Improbable-Association/ISS/plans_enceintes/hornplans-marc-o-mth-4654-169785.jpg

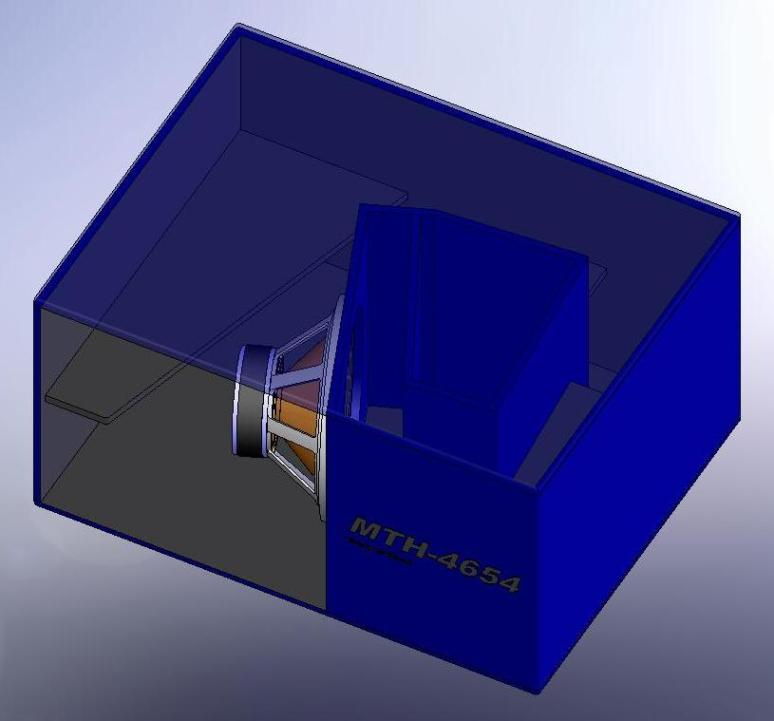
plans_enceintes/hornplans-marc-o-mth-4654-169785.jpg
