Improbable-Association/ISS/plans_enceintes/plan_iss_medium.docx

Tf0818

3cm-e

30cm+2*e

21.8cm+2*e+2cm

D=18.5cm

25.3cm

4.7cm

25.9cm
