Improbable-Association/ISS/plans_enceintes/bbc br215 modif 12 tricone.odt

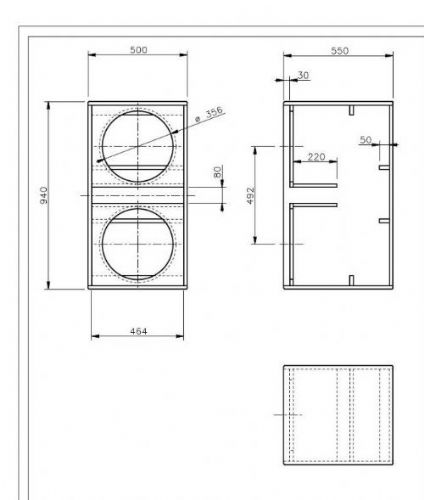
[picture p7: figure]

536 285,75 836 366 500 102 32 349 451
