Improbable-Association/ISS/2022-11-07-Cablage-ISS-4654-triple-DE10-STEREO.pdf

# Fiche d’installation Improbable Sound System + MTH4654s + Triple + DE10 + STEREO

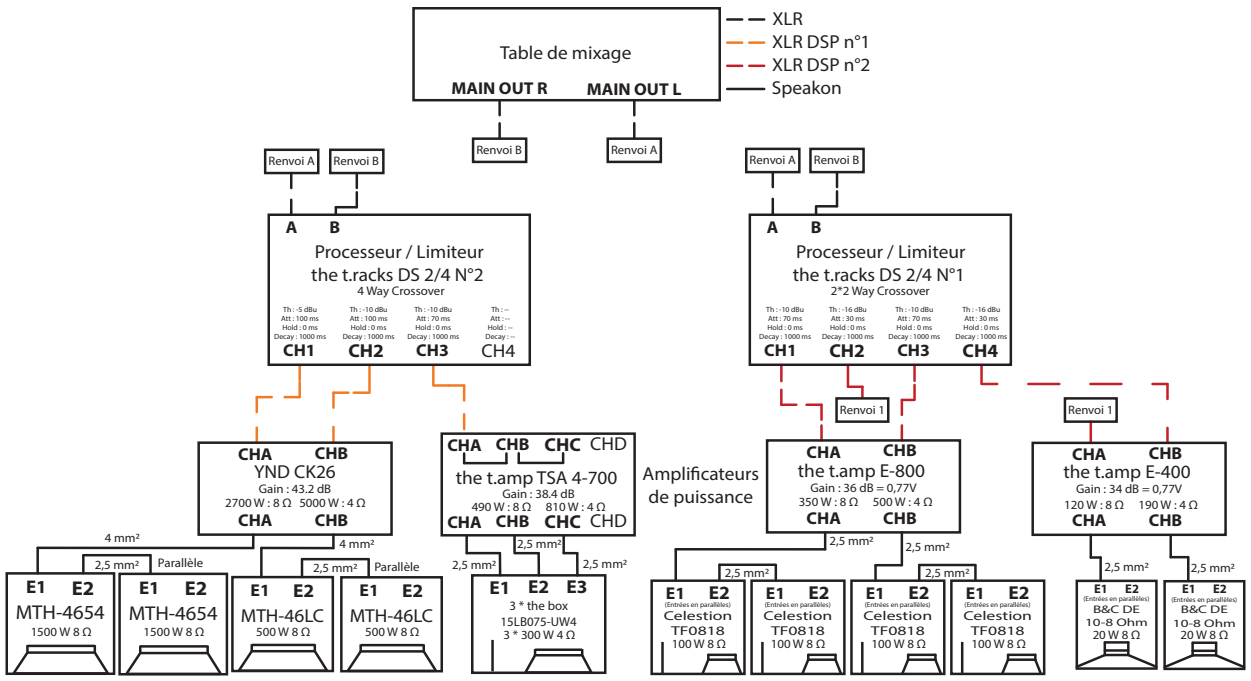
[picture p14: figure]
Amplicateurs de puissance; XLR DSP n°2 Speakon; XLR XLR DSP n°1; Parallèle; Table de mixage; MAIN OUT R; MAIN OUT L; E1 E2 MTH-4654; Celestion TF0818; E1 E2 (Entrées en parallèles); 3 * the box 15LB075-UW4; E1 E2 MTH-46LC 500 W 8 Ω; CHA; CHB; YND CK26 Gain : 43.2 dB; CHA CHB CHC CHD; the t.amp TSA 4-700 Gain : 38.4 dB; the t.amp E-800; Gain : 36 dB = 0,77V 350 W : 8 Ω 500 W : 4 Ω; the t.amp E-400; Gain : 34 dB = 0,77V 120 W : 8 Ω 190 W : 4 Ω; Processeur / Limiteur the t.racks DS 2/4 N°2; Th : -5 dBu Att : 100 ms Hold : 0 ms Decay : 1000 ms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
Sur le DS 2/4; Xover sub menu; MENU; ENTER; Load a Xover; Recherche de la conguration avec la molette

# Document réalisé par Florian Vié Contact :

# Téléphone : 06.52.60.95.78

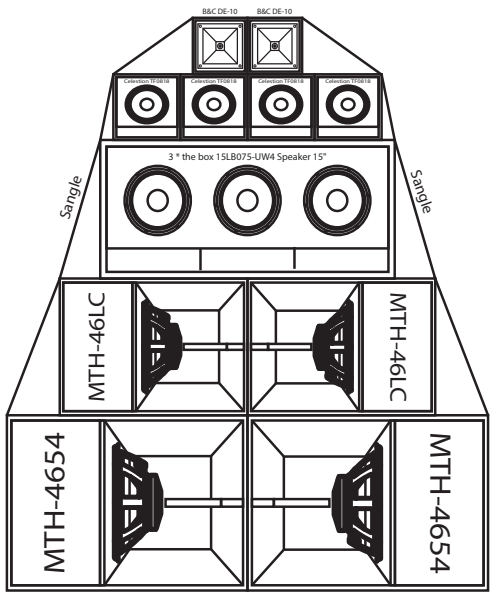
[picture p15: figure]
3 * the box 15LB075-UW4 Speaker 15"; Sangle; MTH-46LC; MTH-4654; Celestion TF0818

# Fiche d’installation Improbable Sound System

# Avertissement :

Les personnes ayant réalisées ces systèmes et écrit cette notice ne sauraient en aucun cas être responsable d’une mauvaise interprétation, mauvais usage, de ces systèmes et de ce document. Il incombe à l’utilisateur d’en faire le bon usage. Si vous avez le moindre doute, contactez les créateurs de ces systèmes et de ce document ou faite régler ces systèmes par un professionnel.

# Mail : vie.orian34@orange.fr

# 4. Choix de la conguration

# ENTER 3. Allumage des appareils

# Monter le volume au maximum :

# YND CK26 : Canal A et B TSA 4-700 : Canal A, B, C E-800 : Canal A et B E-400 : Canal A et B

# 2. Diposition des enceintes

# En stack (par défaut)

# 1. Mise en place de la régie

2700 W : 8 Ω 5000 W : 4 Ω | 490 W : 8 Ω 810 W : 4 Ω
Renvoi B | Renvoi A Renvoi A | Renvoi B | Renvoi A | Renvoi B
