Improbable-Association/ISS/plans_enceintes/c15modif.pdf

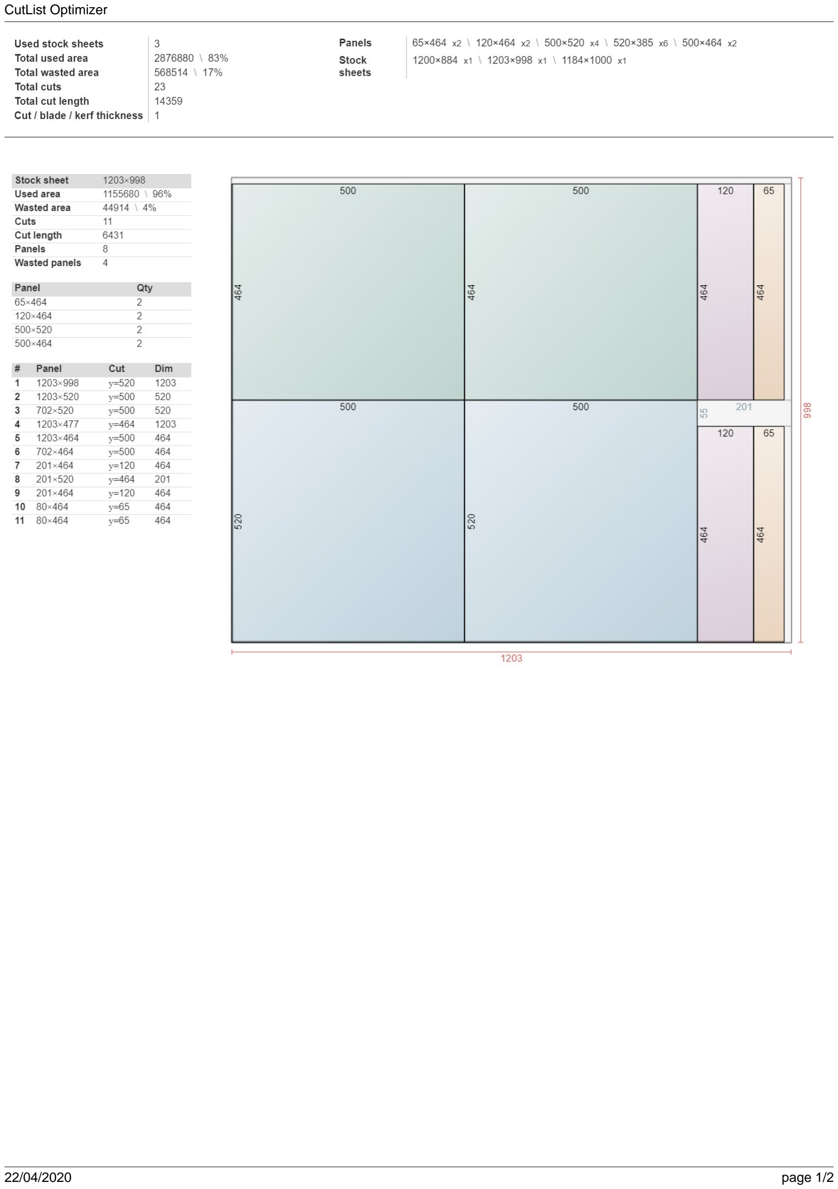
[picture p16: page 1]

CutList Optimizer

22/04/2020 | page 1/2

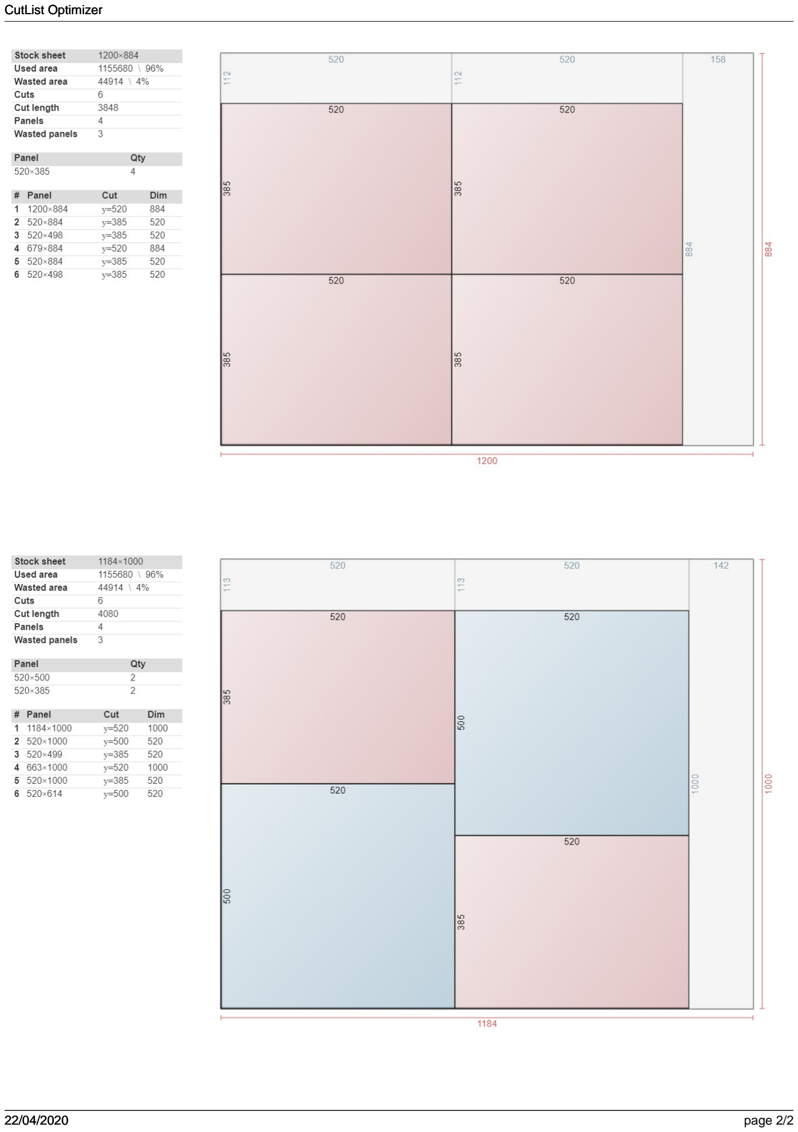
[picture p17: page 2]

CutList Optimizer

22/04/2020 | page 2/2
