Improbable-Association/ISS/plans_enceintes/focal 165 pc laminaire.pdf

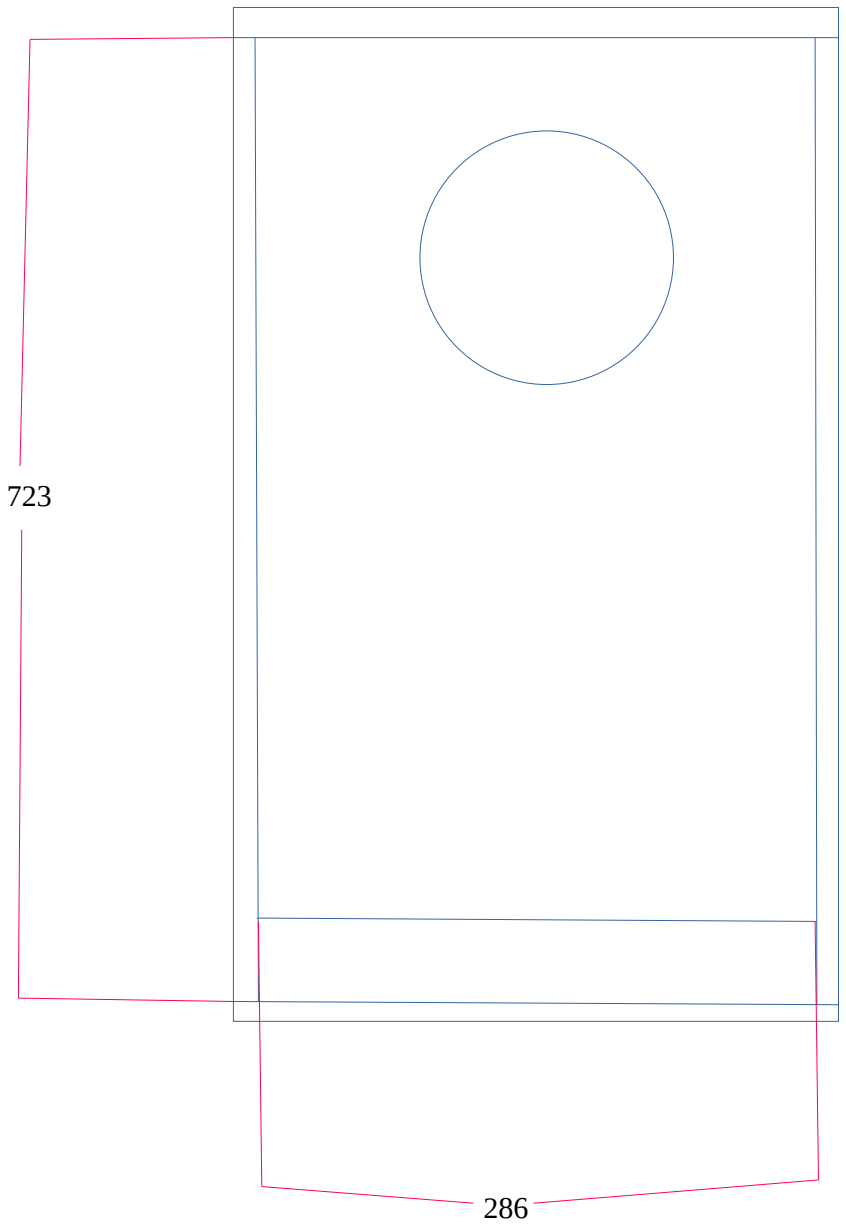
[picture p18: figure]

461

20

47
