Improbable-Association/ISS/plans_enceintes/mhb plan.pdf

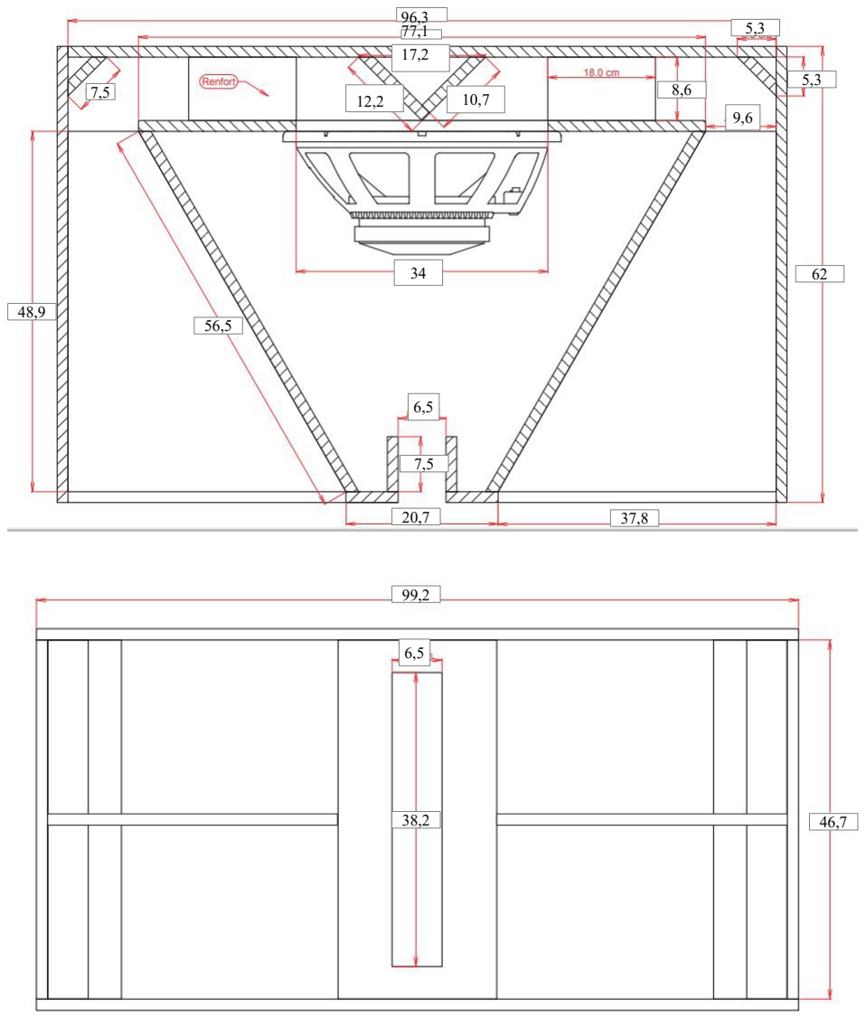
[picture p19: page 1]

96,3
77,1
17,2
12,2 | 10,7 7,5

5,3

5,3 8,6

9,6

34 | 62

48,9
56,5

6,5

7,5

20,7 | 37,8

99,2

38,2

6,5

46,7
