Improbable-Association/ISS/plans_enceintes/mkh 230 plaque leroy.pdf

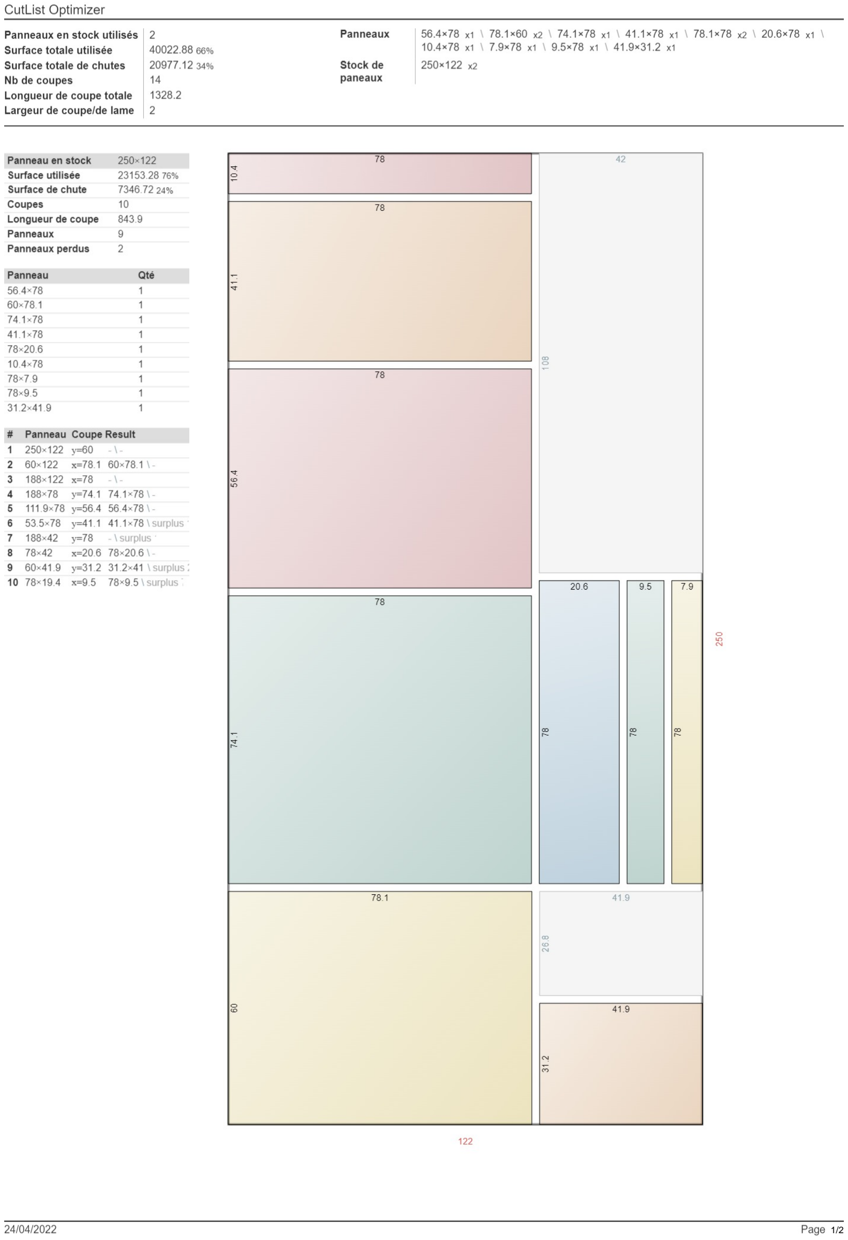
[picture p20: page 1]

1/2

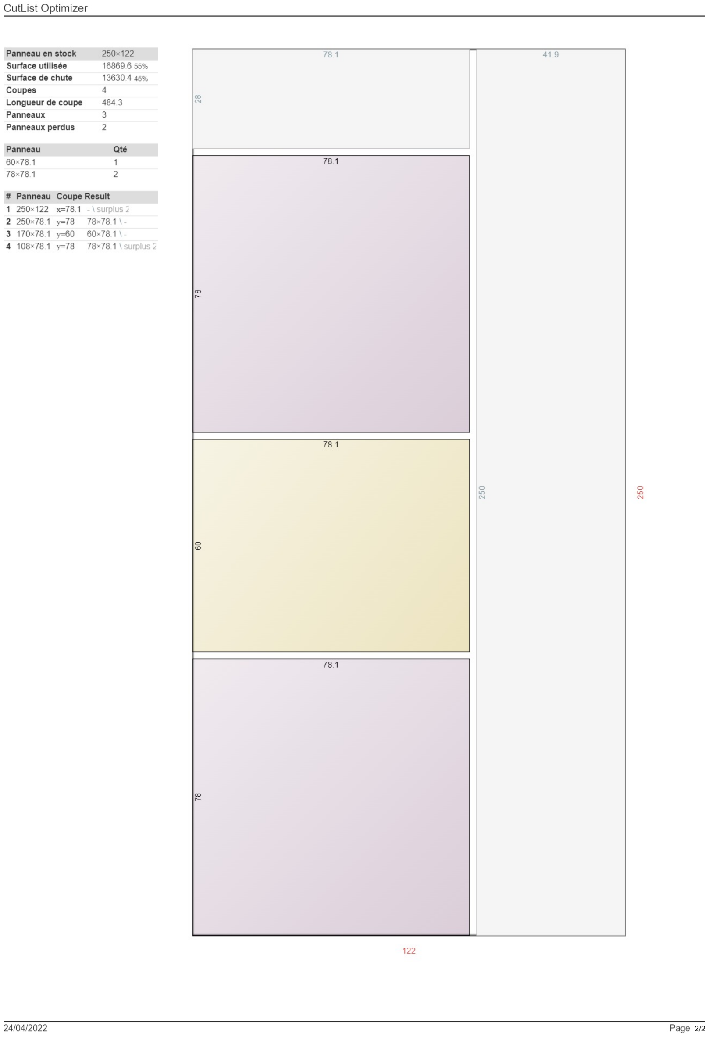
[picture p21: page 2]

2/2
