Improbable-Association/ISS/plans_enceintes/SAKB28 Plan.pdf

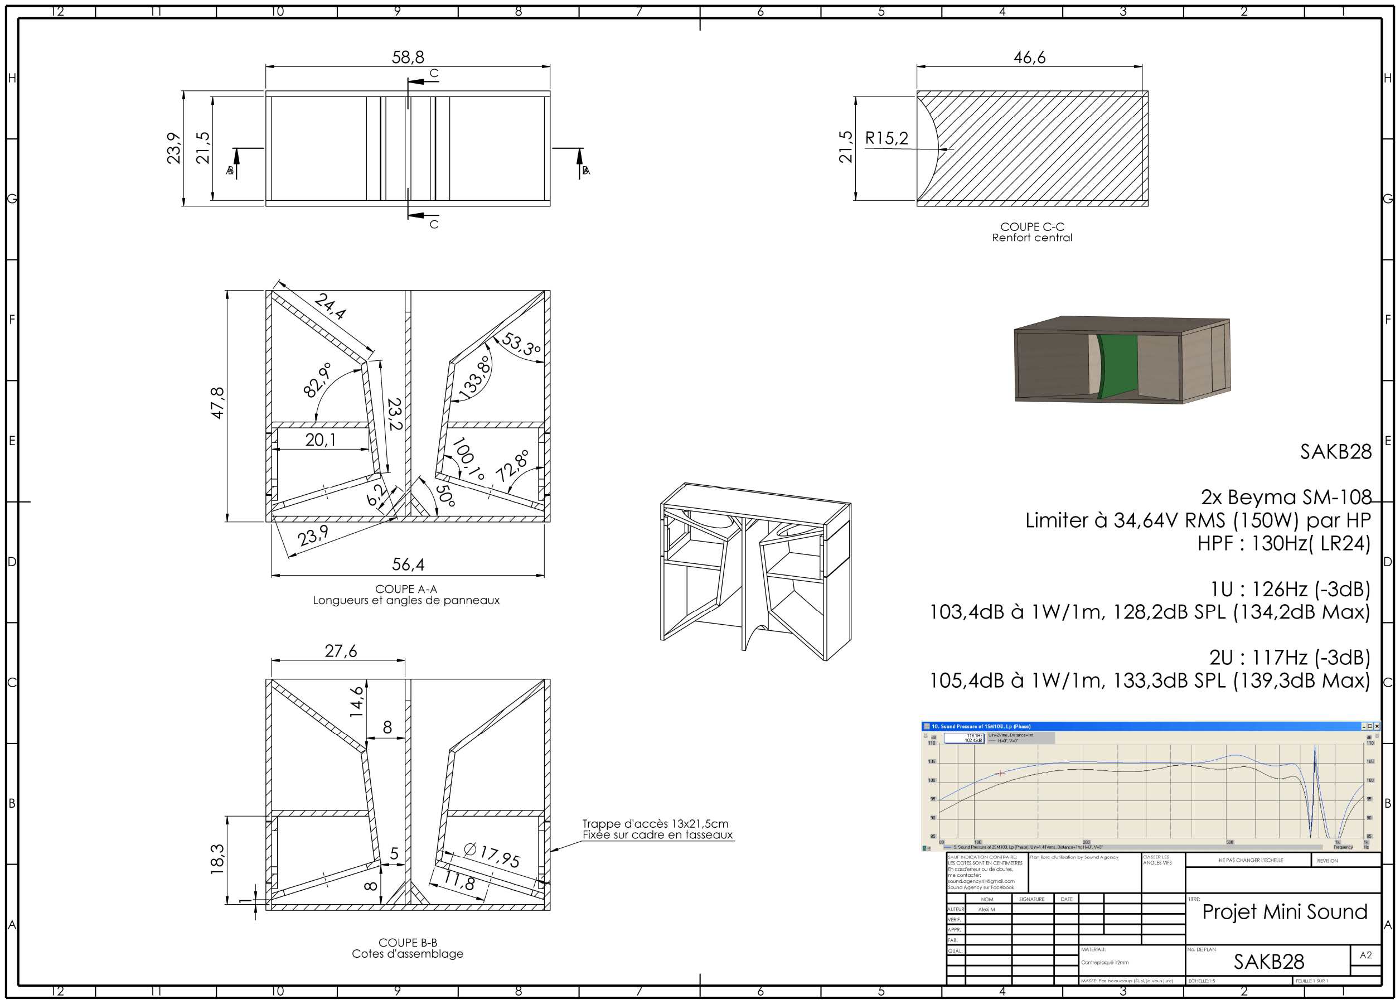
[picture p22: page 1]
