Improbable-Association/ISS/plans_enceintes/Tham 15 modifie.pdf

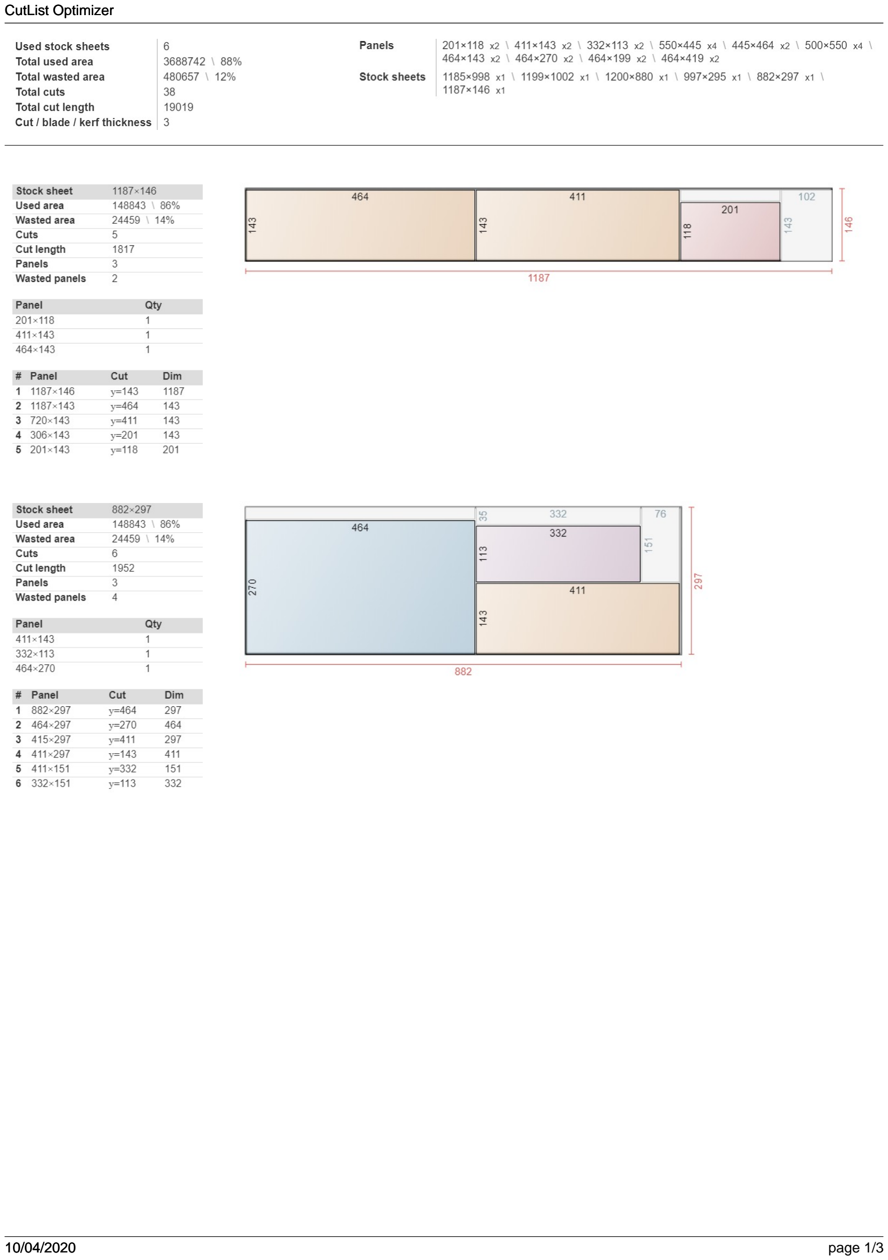
[picture p23: page 1]

CutList Optimizer

10/04/2020 | page 1/3

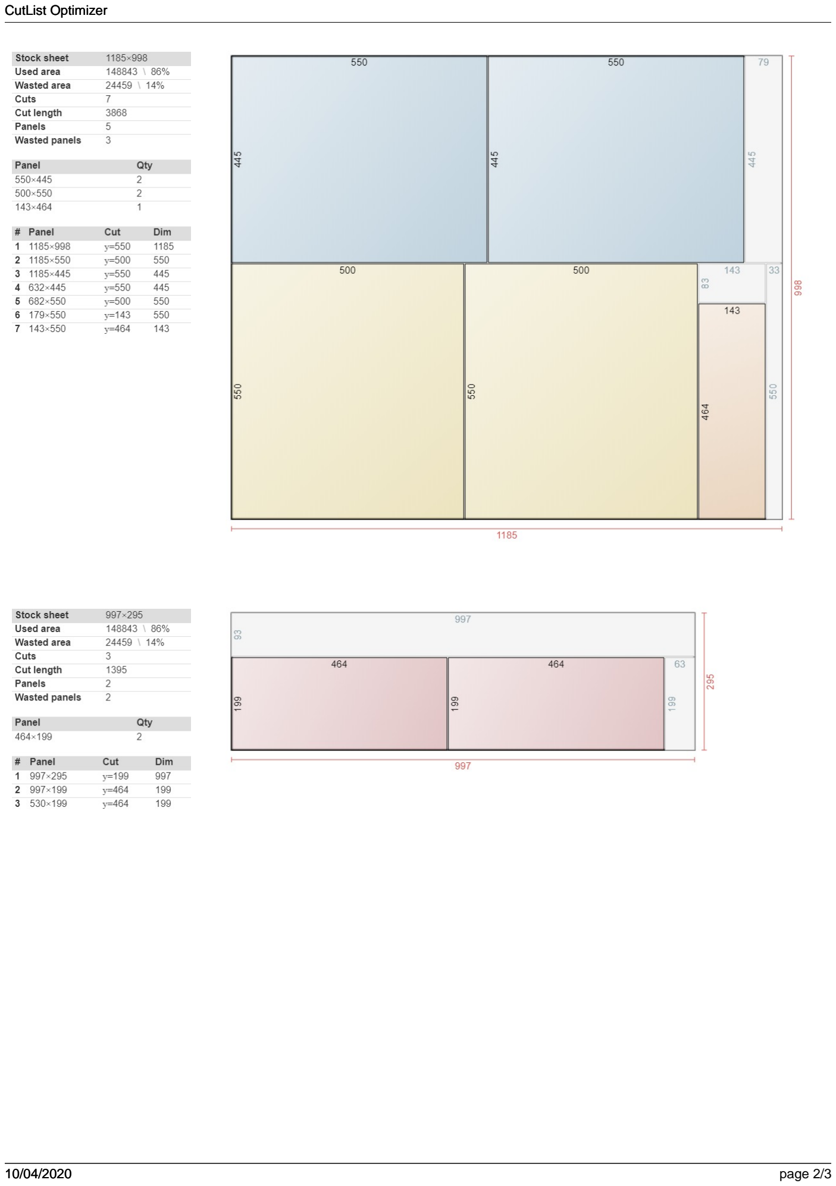
[picture p24: page 2]
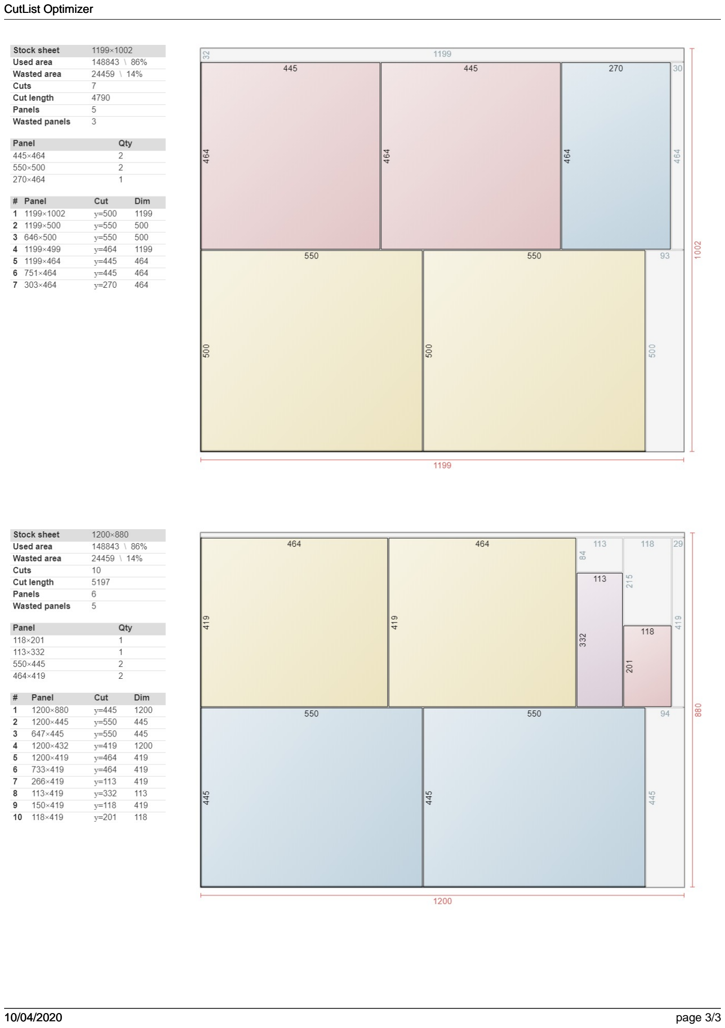
[picture p25: page 3]
