Improbable-Association/ISS/plans_enceintes/tham 15.pdf

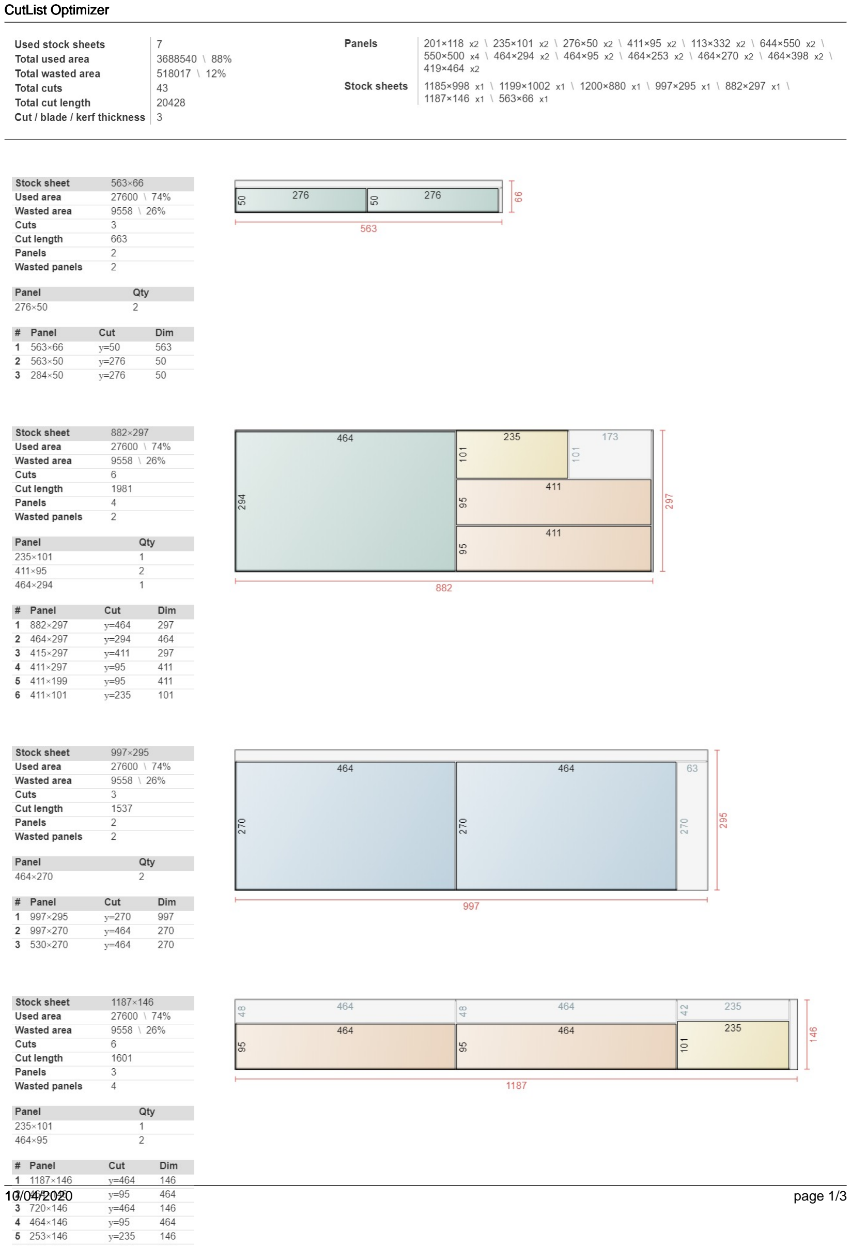
[picture p26: page 1]

CutList Optimizer

10/04/2020 | page 1/3

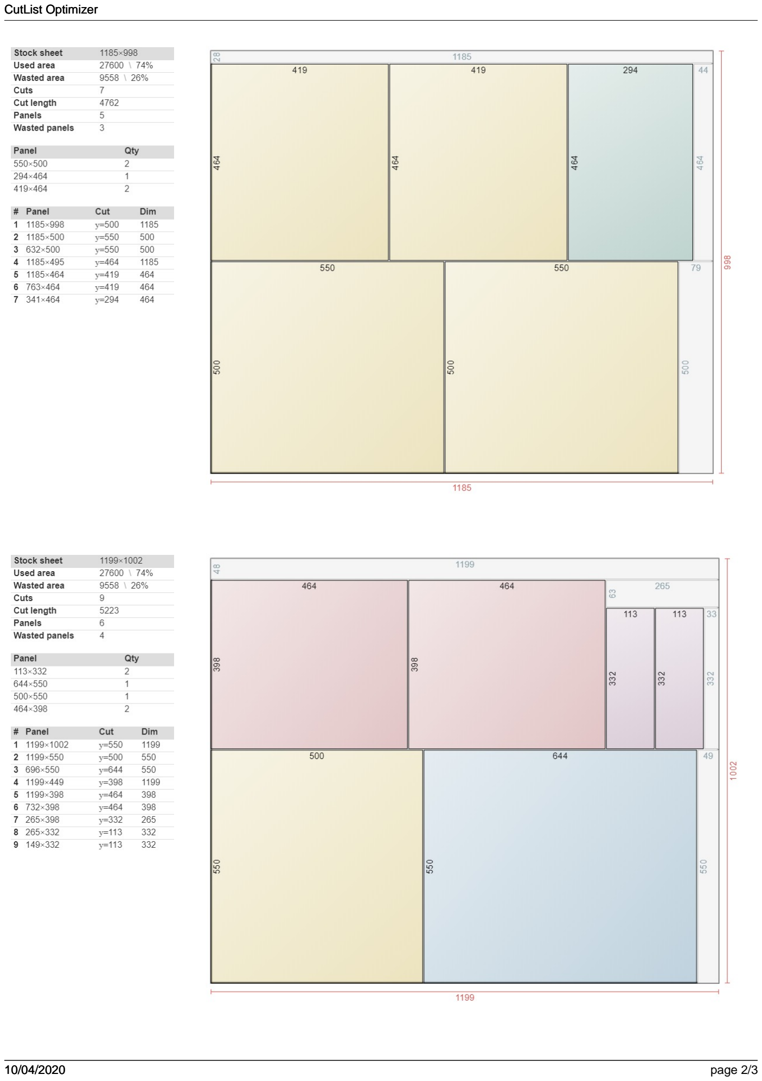
[picture p27: page 2]
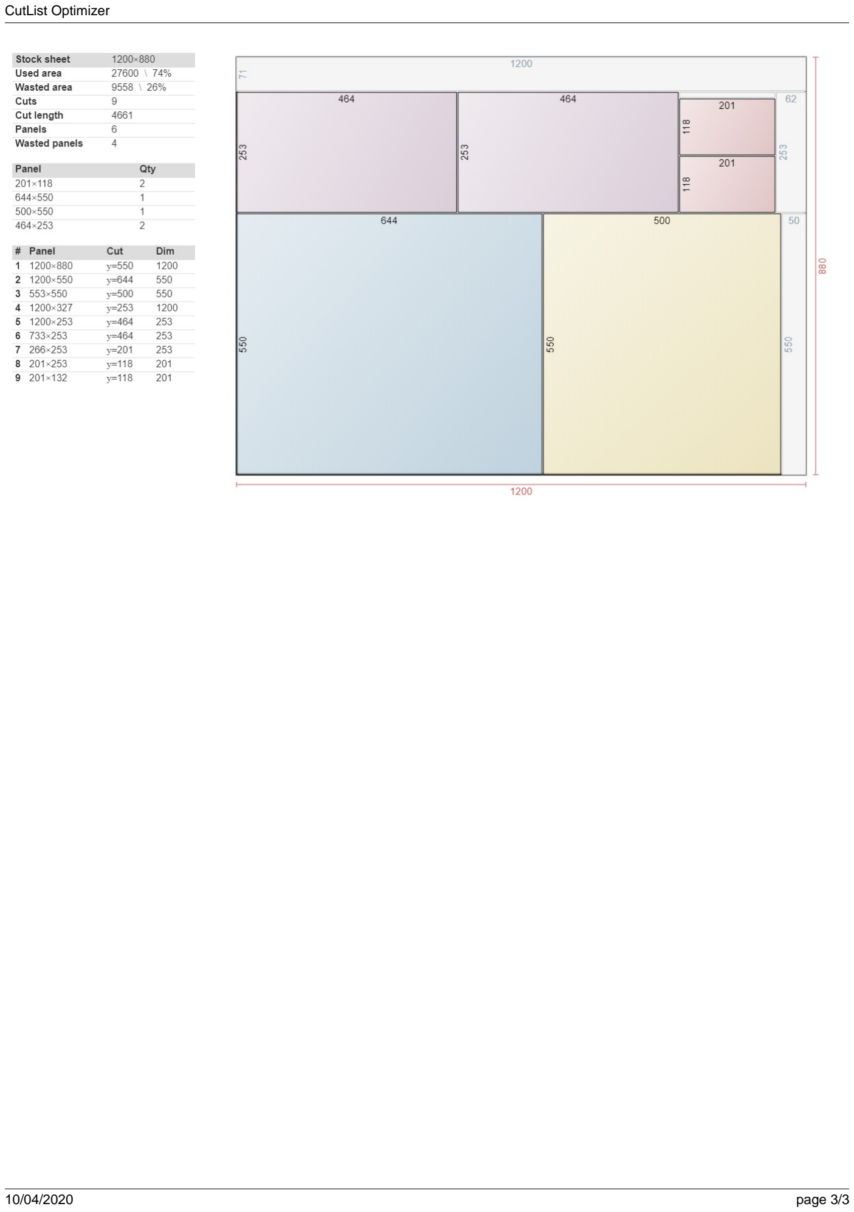
[picture p28: page 3]
