Improbable-Association/ISS/plans_enceintes/triple15thomann-planches.pdf

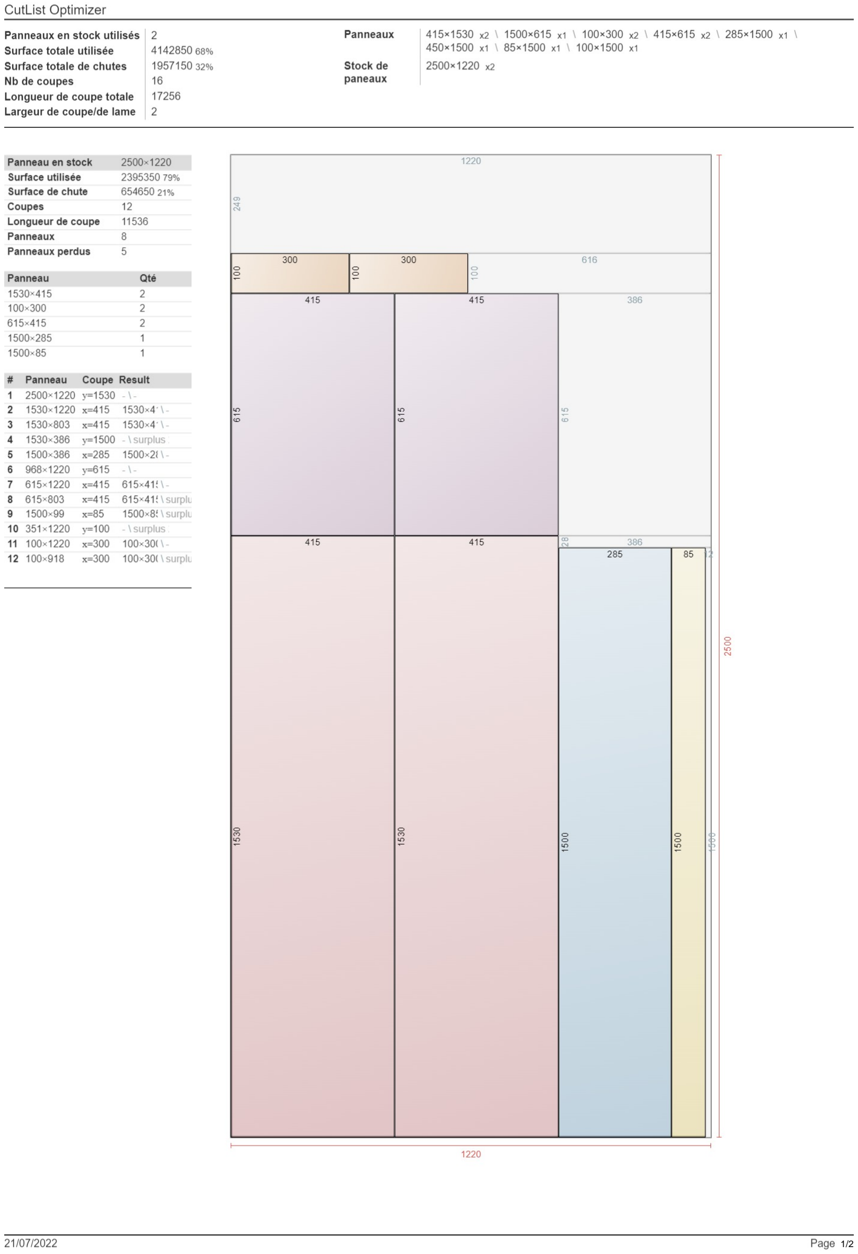
[picture p29: page 1]

1/2

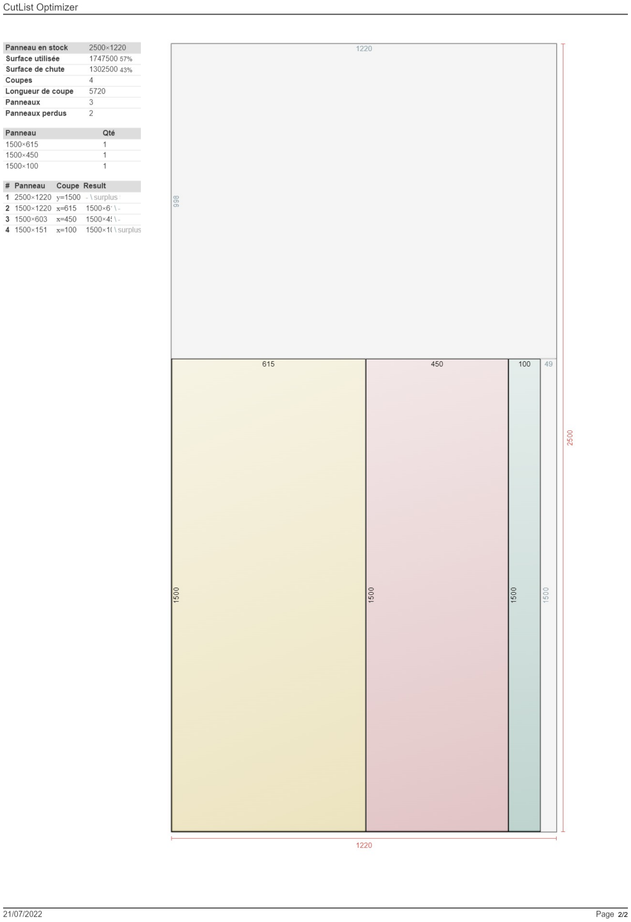
[picture p30: page 2]

2/2
