Improbable-Association/ISS/plans_enceintes/c15 modif.jpg

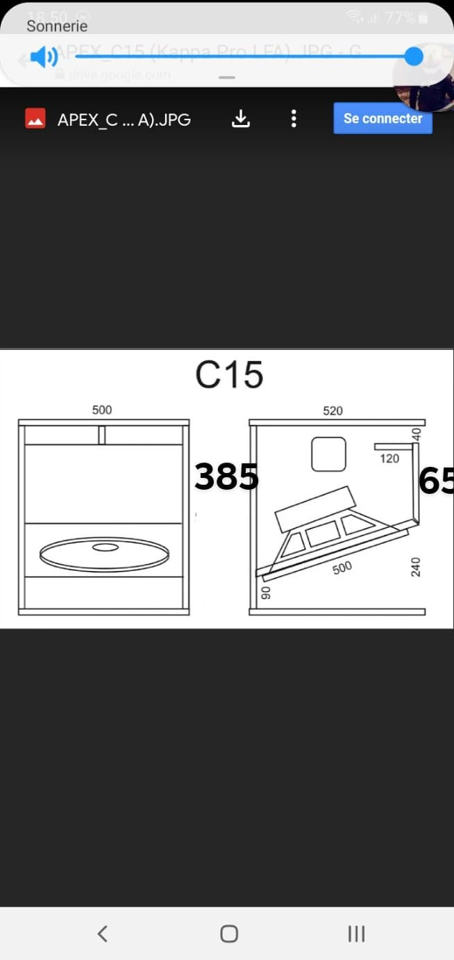
plans_enceintes/c15 modif.jpg
