Improbable-Association/ISS/plans_enceintes/compact_v8HYB.step

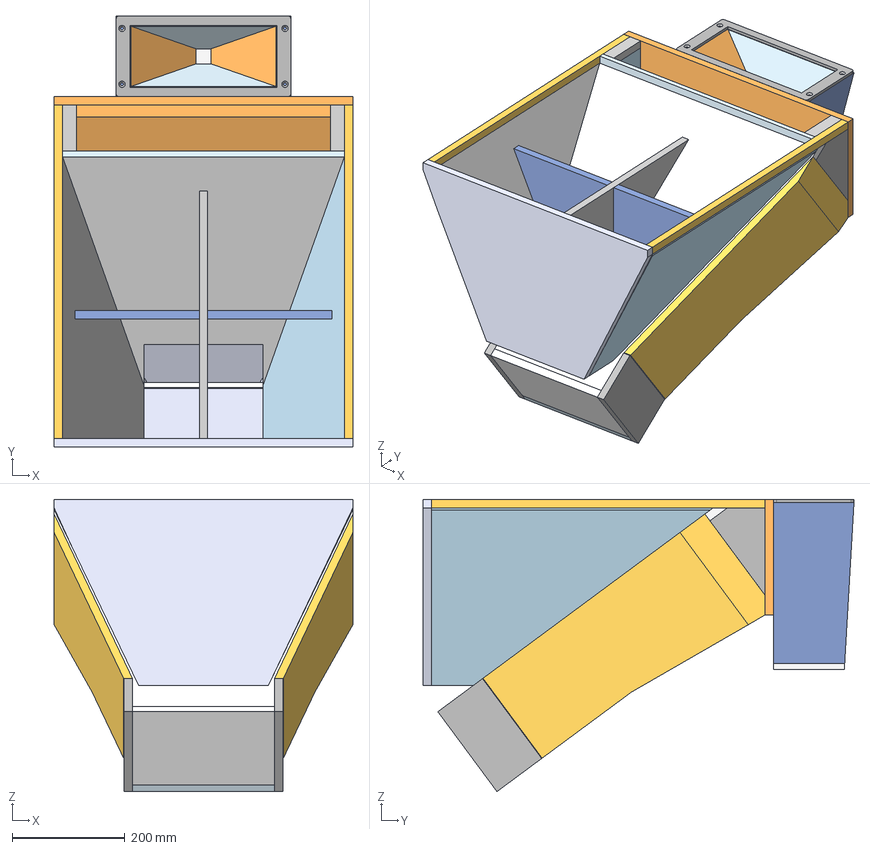
[picture p32: CAD file, 2025-05-29]
plans_enceintes/compact_v8HYB.step
530.0 x 764.6 x 518.4 mm
