Improbable-Association/ISS/plans_enceintes/triple15thomann15mmversion.SLDPRT

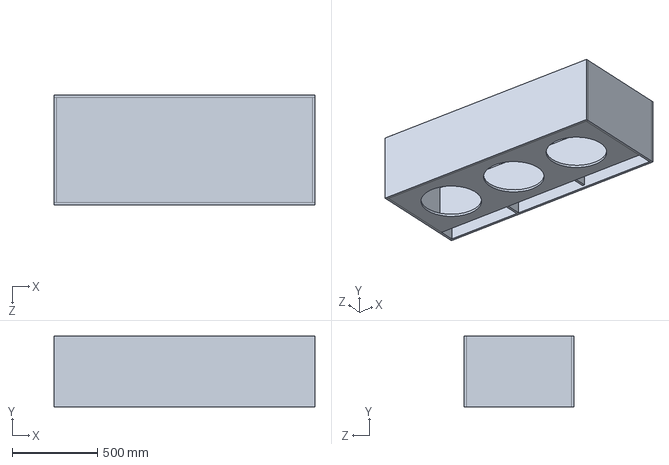
[picture p33: CAD file, 2025-05-28]
plans_enceintes/triple15thomann15mmversion.SLDPRT
1530.0 x 415.0 x 645.0 mm
