Improbable-Association/ISS/plans_enceintes/triple15thomann.SLDPRT

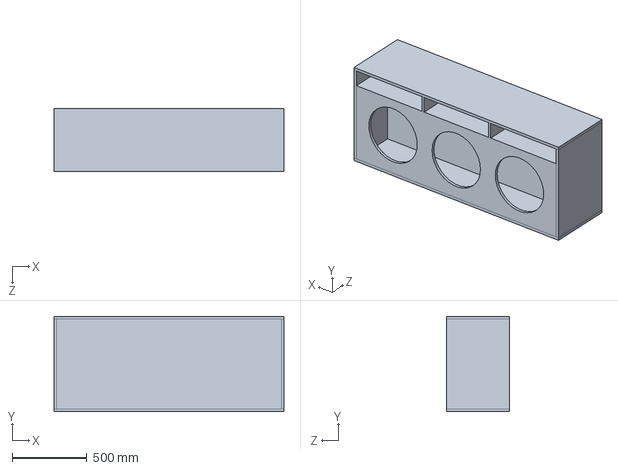
[picture p34: CAD file, 2025-05-28]
plans_enceintes/triple15thomann.SLDPRT
1536.0 x 636.0 x 418.0 mm
