Improbable-Association/ISS/(list of files, cad)

Other CAD files:
plans_enceintes/triple15thomann.SLDDRW
plans_enceintes/triple15thomann15mmversion.SLDDRW
