Improbable-Association/ISS/plans_enceintes/HessBH-Plan-2.pdf

6

5

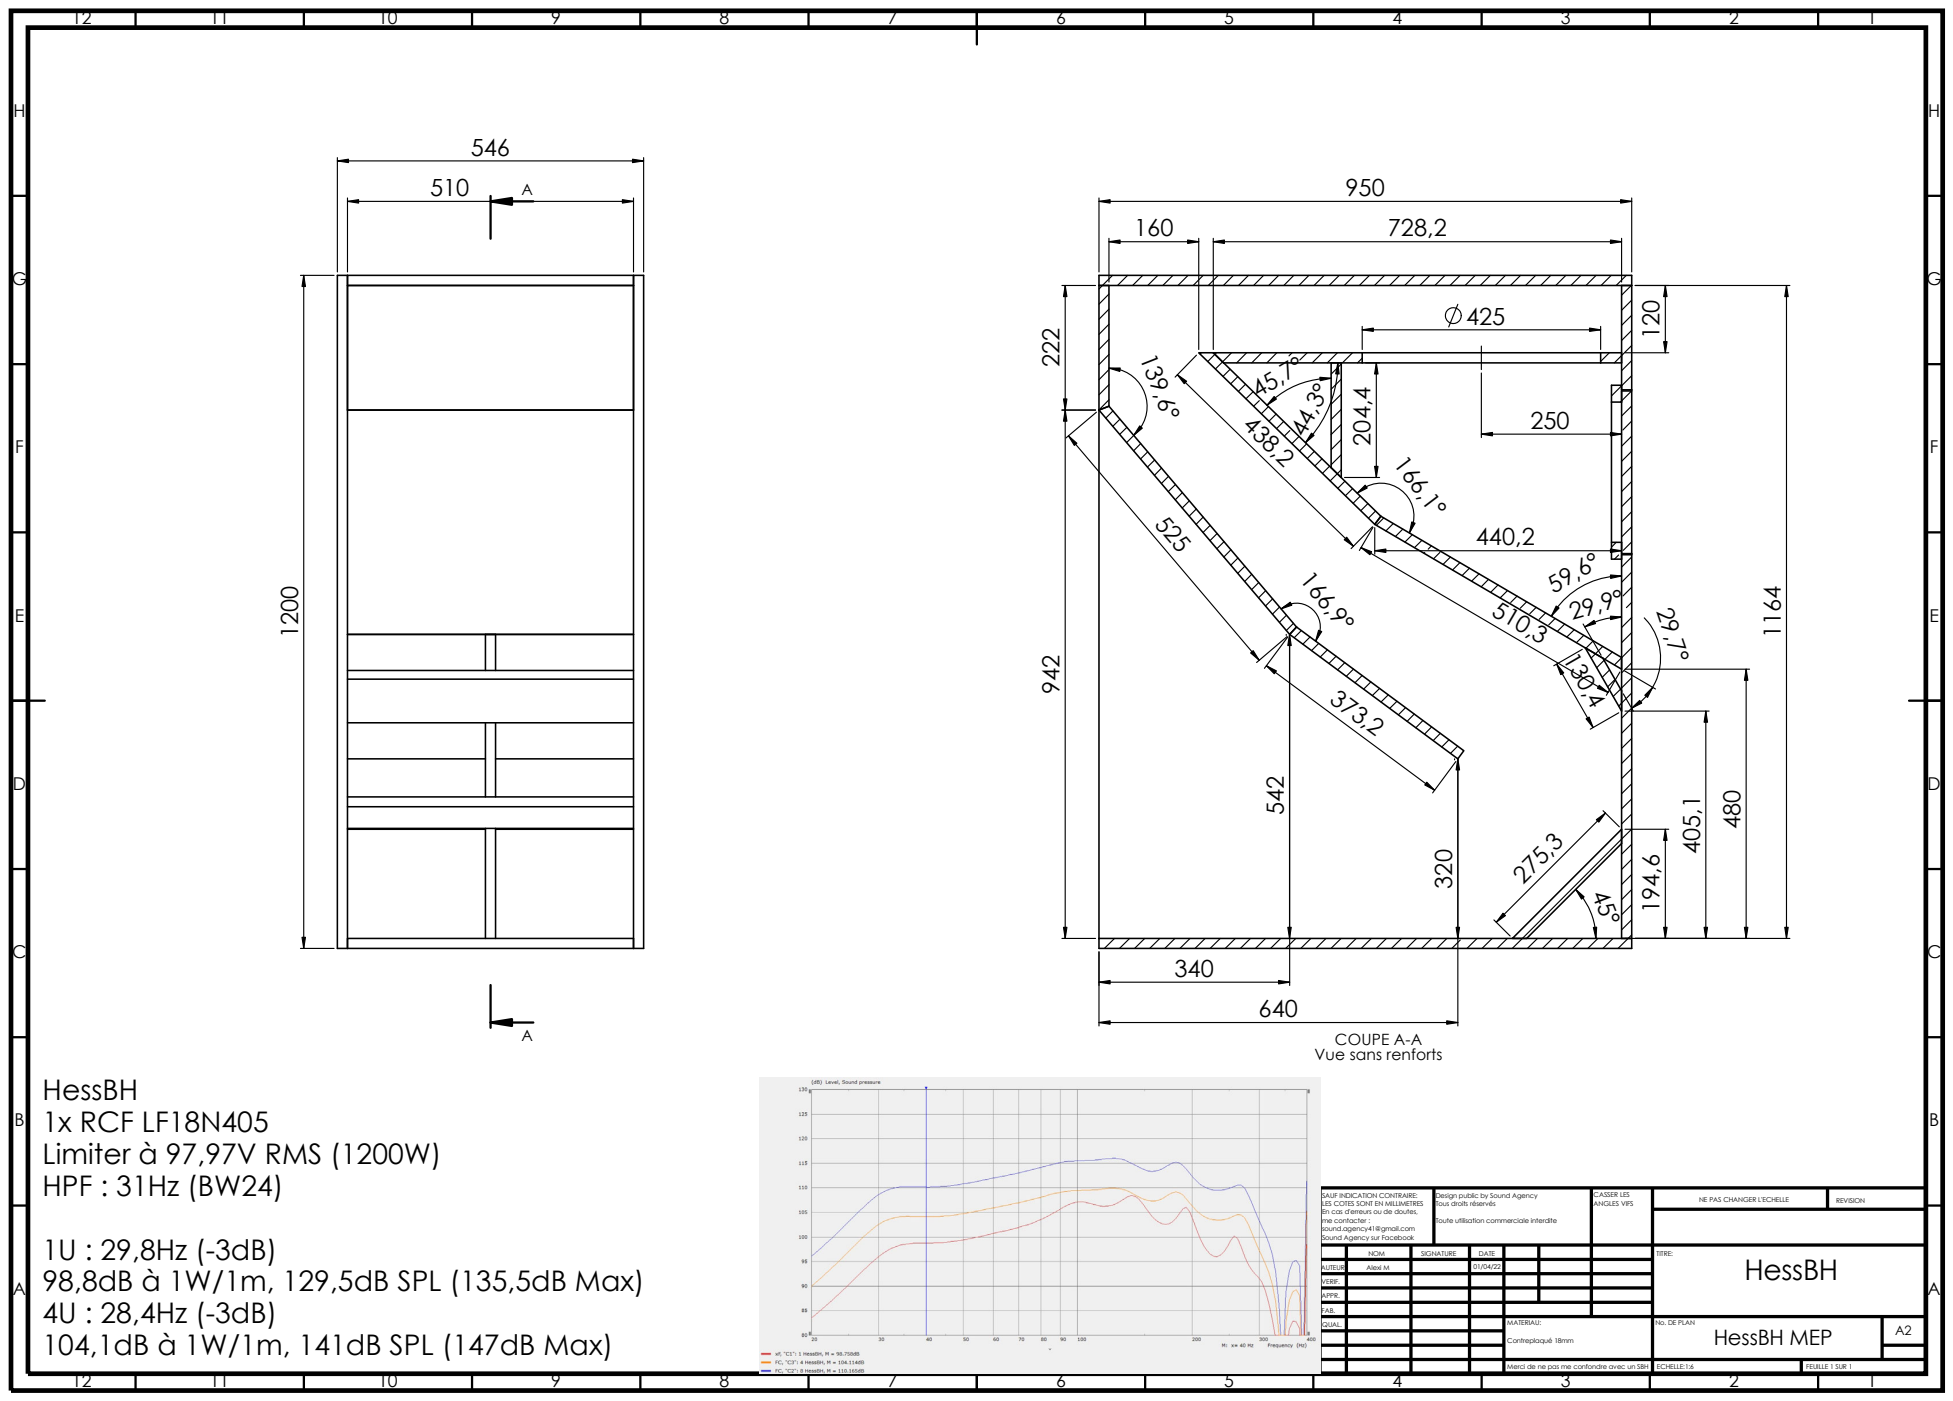
[picture p35: page 1]
HessBH 1x RCF LF18N405 Limiter à 97,97V RMS (1200W) HPF : 31Hz (BW24); 1U : 29,8Hz (-3dB) 98,8dB à 1W/1m, 129,5dB SPL (135,5dB Max) 4U : 28,4Hz (-3dB) 104,1dB à 1W/1m, 141dB SPL (147dB Max); ANGLES VIFS; TITRE:; me contacter :; Toute utilisation commerciale interdite; NOM; SIGNATURE; REVISION; DATE; MATERIAU:; ECHELLE:1:6; FEUILLE 1 SUR 1; Contreplaqué 18mm; Design public by Sound Agency; CASSER LES

COUPE A-A
Vue sans renforts

SAUF INDICATION CONTRAIRE:
LES COTES SONT EN MILLIMETRES
En cas d'erreurs ou de doutes,
sound.agency41@gmail.com
Sound Agency sur Facebook

Tous droits réservés

NE PAS CHANGER L'ECHELLE
HessBH

AUTEUR | Alexi M | 01/04/22
VERIF.
APPR.
FAB. QUAL.

No. DE PLAN
HessBH MEP

Merci de ne pas me confondre avec un SBH

914

2

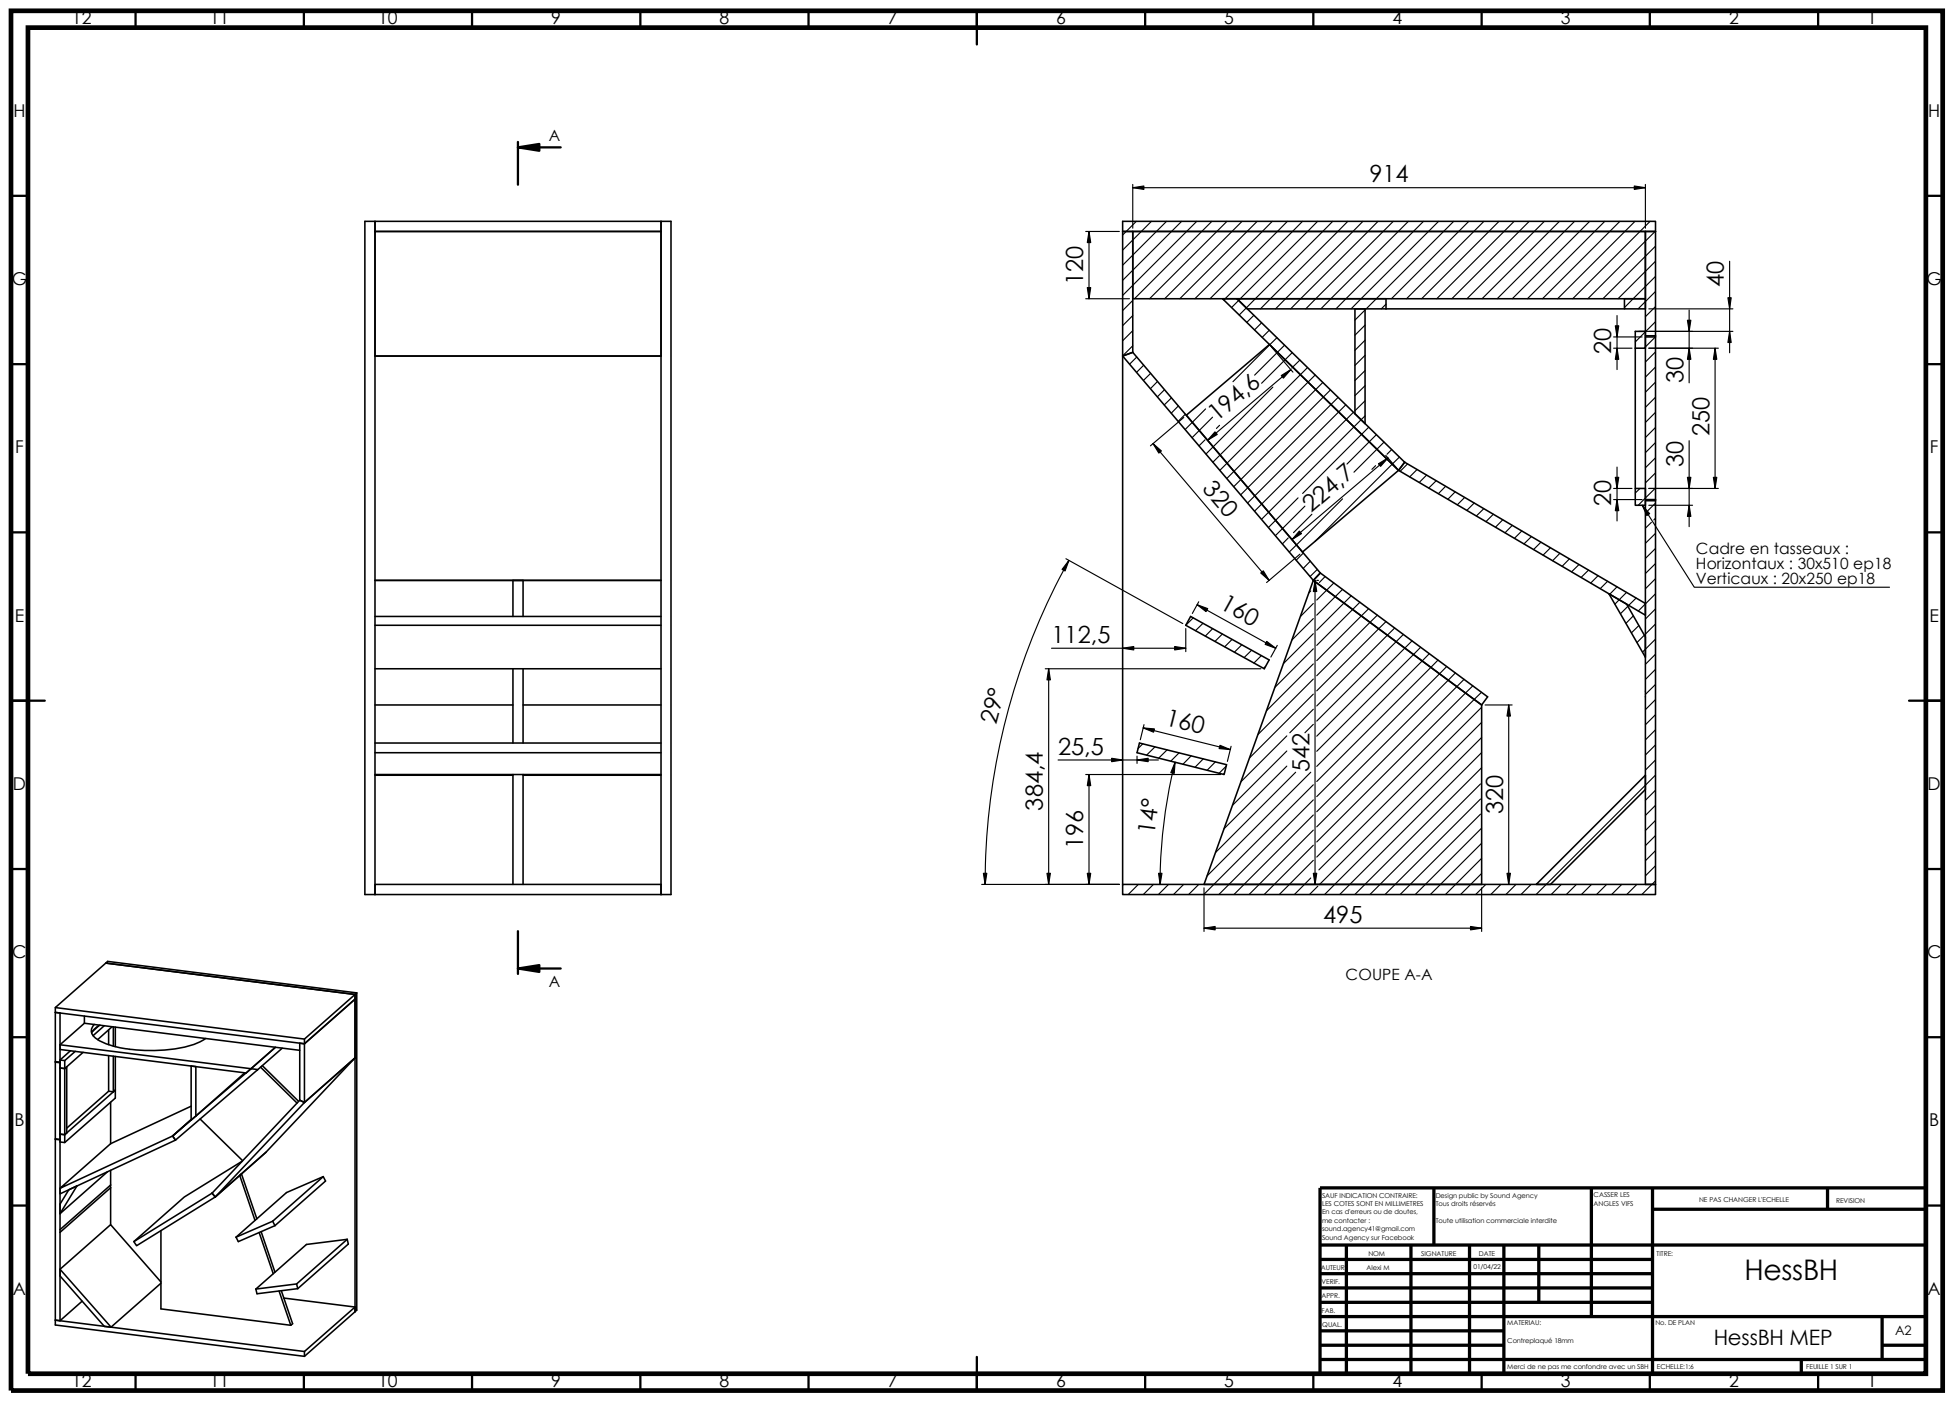
[picture p36: page 2]
COUPE A-A; me contacter :; Toute utilisation commerciale interdite; Tous droits réservés; ANGLES VIFS; NOM; SIGNATURE; DATE; MATERIAU:; NE PAS CHANGER L'ECHELLE; REVISION; TITRE:; ECHELLE:1:6; FEUILLE 1 SUR 1; HessBH; Contreplaqué 18mm; Design public by Sound Agency; CASSER LES

Cadre en tasseaux :
Horizontaux : 30x510 ep18
Verticaux : 20x250 ep18

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

AUTEUR | Alexi M | 01/04/22
VERIF.
APPR.
FAB. QUAL.

No. DE PLAN
HessBH MEP

Merci de ne pas me confondre avec un SBH
