Improbable-Association/ISS/plans_enceintes/MKB-230.pdf

# MKB-230

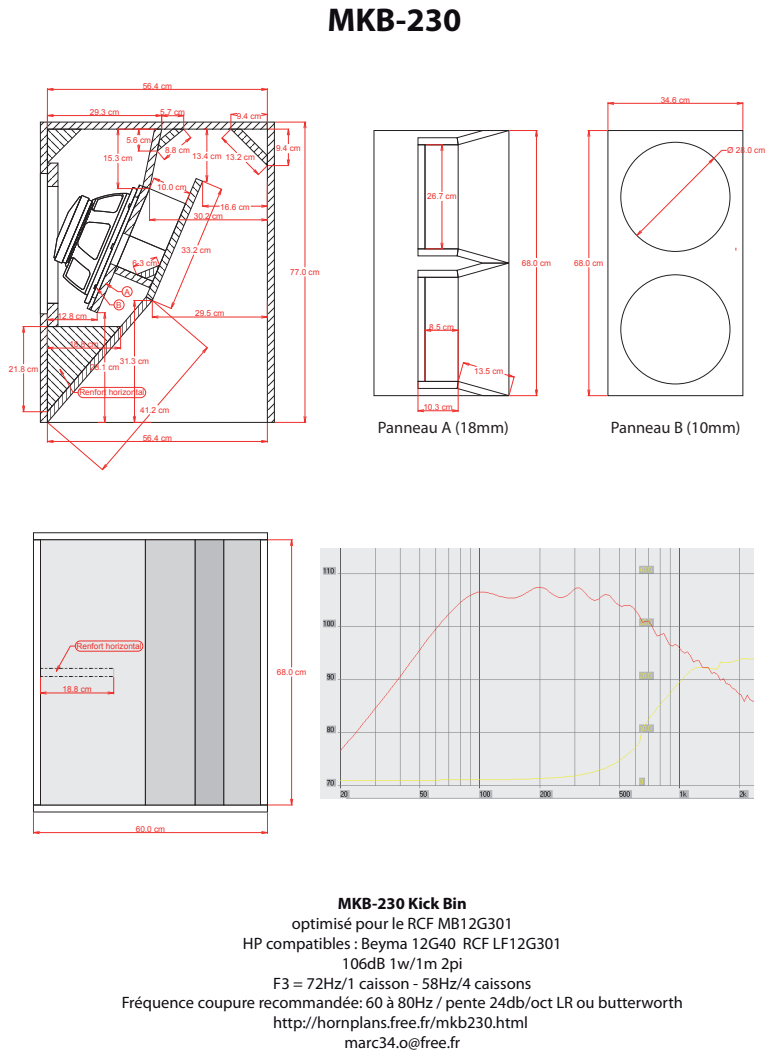
[picture p37: page 1]
106dB 1w/1m 2pi F3 = 72Hz/1 caisson - 58Hz/4 caissons; marc34.o@free.fr; Renfort horizontal; Panneau A (18mm); Panneau B (10mm)

MKB-230 Kick Bin
optimisé pour le RCF MB12G301
HP compatibles : Beyma 12G40 RCF LF12G301

Fréquence coupure recommandée: 60 à 80Hz / pente 24db/oct LR ou butterworth

http://hornplans.free.fr/mkb230.html
