Improbable-Association/ISS/plans_enceintes/MT-130 V2.pdf

MT - 130

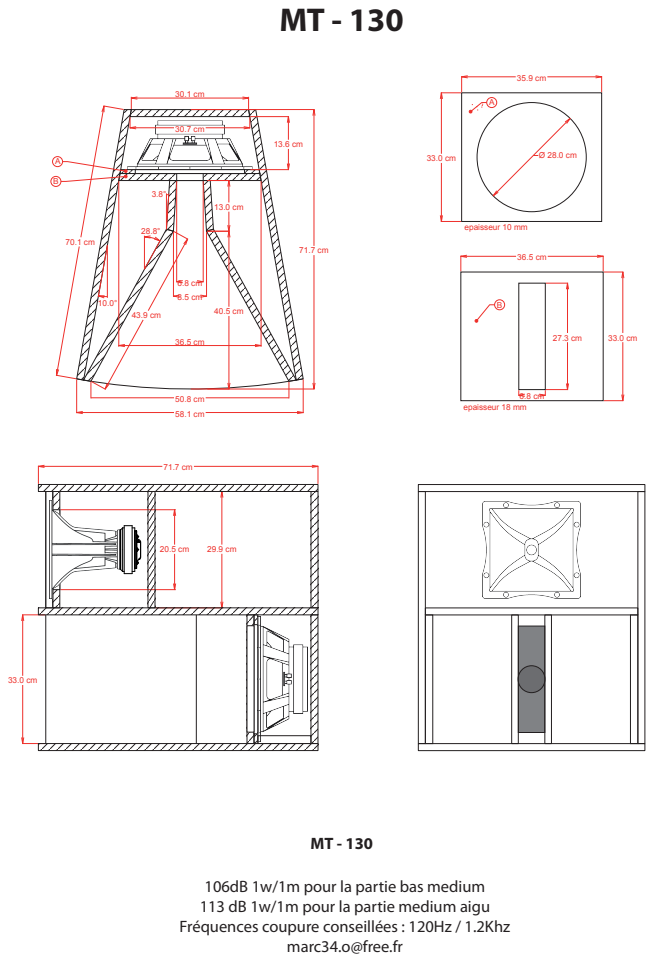
[picture p38: page 1]
epaisseur 10 mm; epaisseur 18 mm; marc34.o@free.fr

106dB 1w/1m pour la partie bas medium
113 dB 1w/1m pour la partie medium aigu
Fréquences coupure conseillées : 120Hz / 1.2Khz
