Improbable-Association/ISS/plans_enceintes/MT-130.pdf

MT - 130

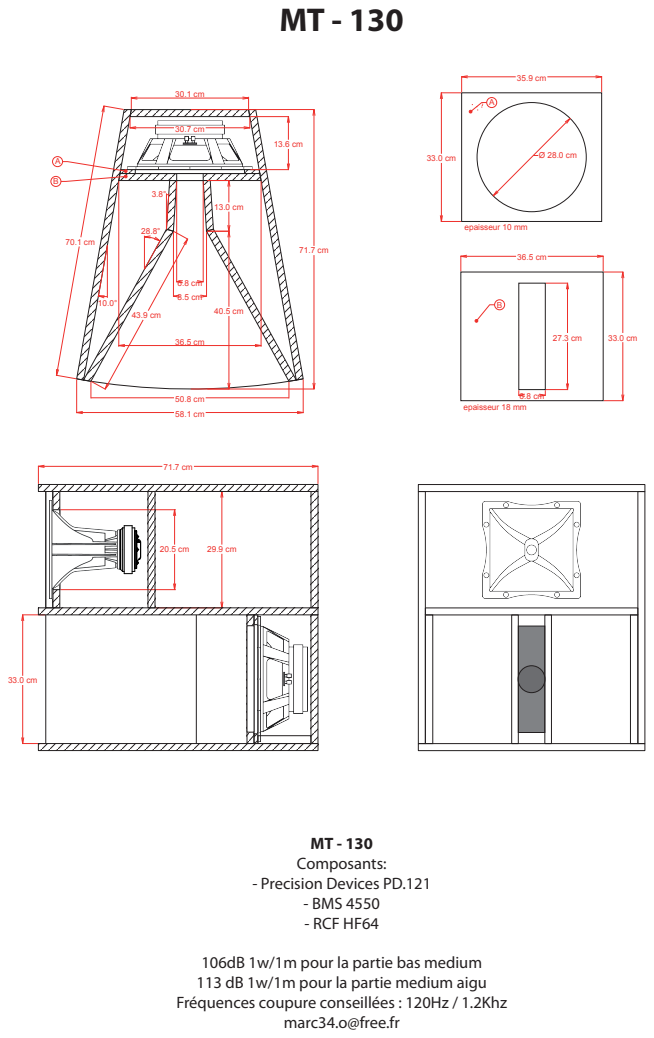
[picture p39: page 1]
epaisseur 10 mm; epaisseur 18 mm; MT - 130 Composants: - Precision Devices PD.121 - BMS 4550 - RCF HF64; marc34.o@free.fr

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
