Improbable-Association/ISS/plans_enceintes/MTB-246.pdf

# MTB - 246

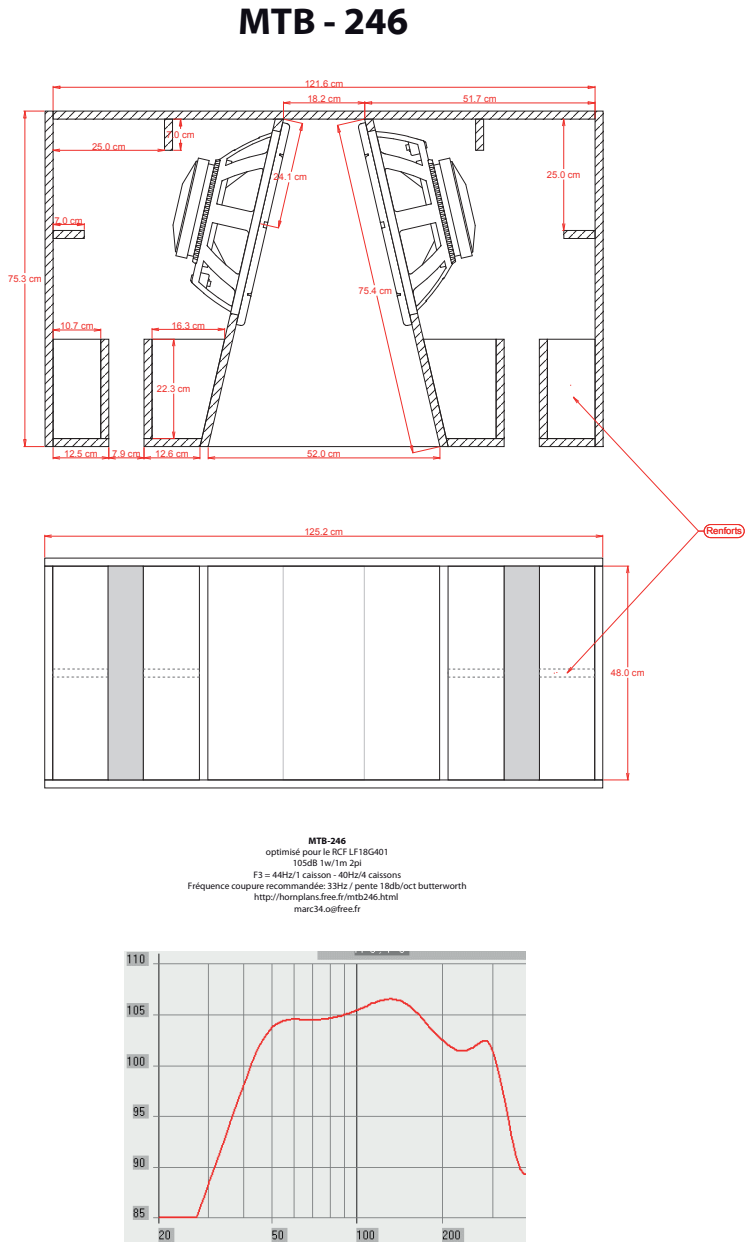
[picture p40: page 1]
Renforts; MTB-246; F3 = 44Hz/1 caisson - 40Hz/4 caissons; marc34.o@free.fr

optimisé pour le RCF LF18G401

Fréquence coupure recommandée: 33Hz / pente 18db/oct butterworth

http://hornplans.free.fr/mtb246.html
