Improbable-Association/ISS/plans_enceintes/MTH-4654.pdf

# MTH-4654

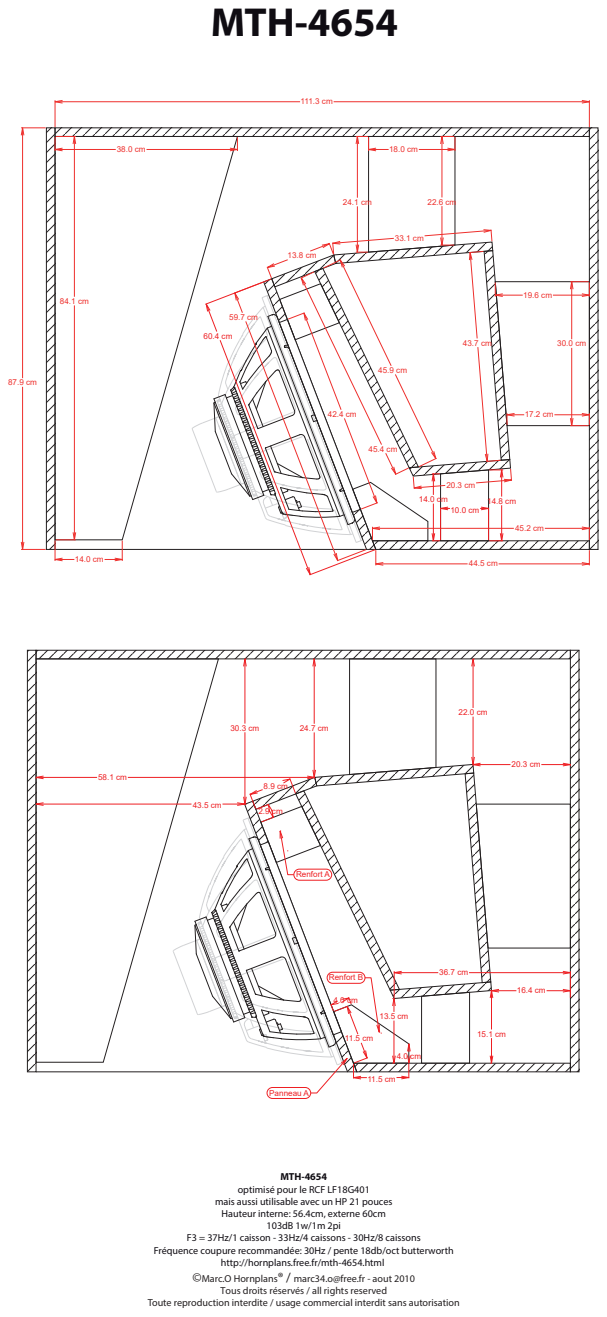
[picture p41: page 1]
MTH-4654; Panneau A; Renfort A; Renfort B

optimisé pour le RCF LF18G401
mais aussi utilisable avec un HP 21 pouces
Hauteur interne: 56.4cm, externe 60cm

F3 = 37Hz/1 caisson - 33Hz/4 caissons - 30Hz/8 caissons
Fréquence coupure recommandée: 30Hz / pente 18db/oct butterworth

http://hornplans.free.fr/mth-4654.html
©Marc.O Hornplans® / marc34.o@free.fr - aout 2010
Tous droits réservés / all rights reserved

Toute reproduction interdite / usage commercial interdit sans autorisation

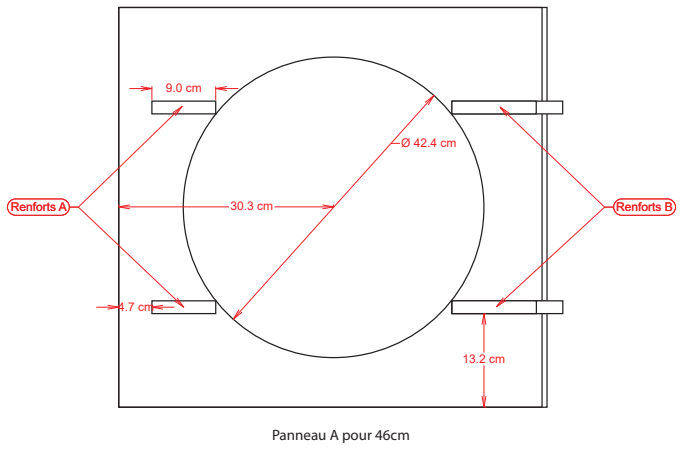
[picture p42: figure]
Renforts A; Renforts B; Panneau A pour 46cm
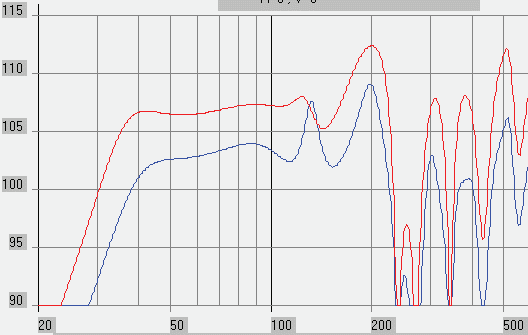
[picture p43: figure]

Courbe réponse:
en bleu: 1 MTH-4654 (1 watt 1métre 2.83 Volts 8 ohms) en rouge : 4 MTH-4654 (1 watt 1 métre 1.41 Volt 2 ohms)

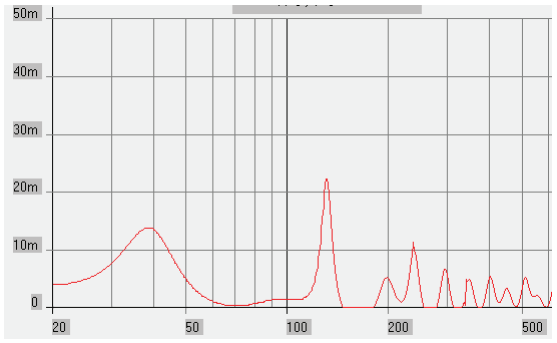
[picture p44: figure]

Group delay
