Improbable-Association/ISS/plans_enceintes/MTH-46LC.pdf

# MTH-46LC

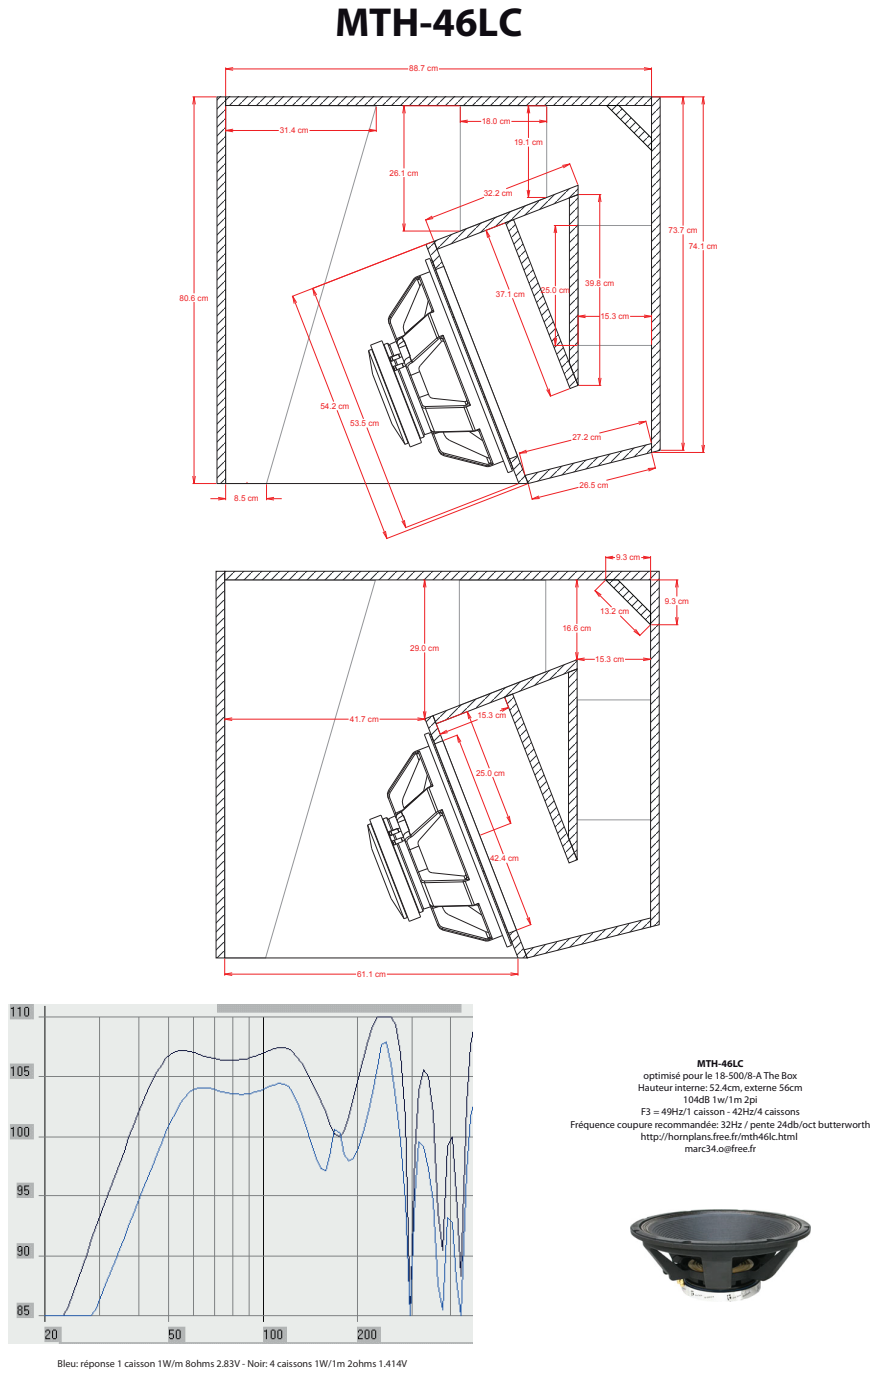
[picture p45: page 1]
MTH-46LC; 104dB 1w/1m 2pi F3 = 49Hz/1 caisson - 42Hz/4 caissons; marc34.o@free.fr

optimisé pour le 18-500/8-A The Box (http://www.thomann.de/index.html?partner_id=93373&page=fr/the_box_speaker_185008a.htm)
Hauteur interne: 52.4cm, externe 56cm

Fréquence coupure recommandée: 32Hz / pente 24db/oct butterworth

http://hornplans.free.fr/mth46lc.html

Bleu: réponse 1 caisson 1W/m 8ohms 2.83V - Noir: 4 caissons 1W/1m 2ohms 1.414V
