Improbable-Association/ISS/plans_enceintes/Compact_V8HYB.pdf

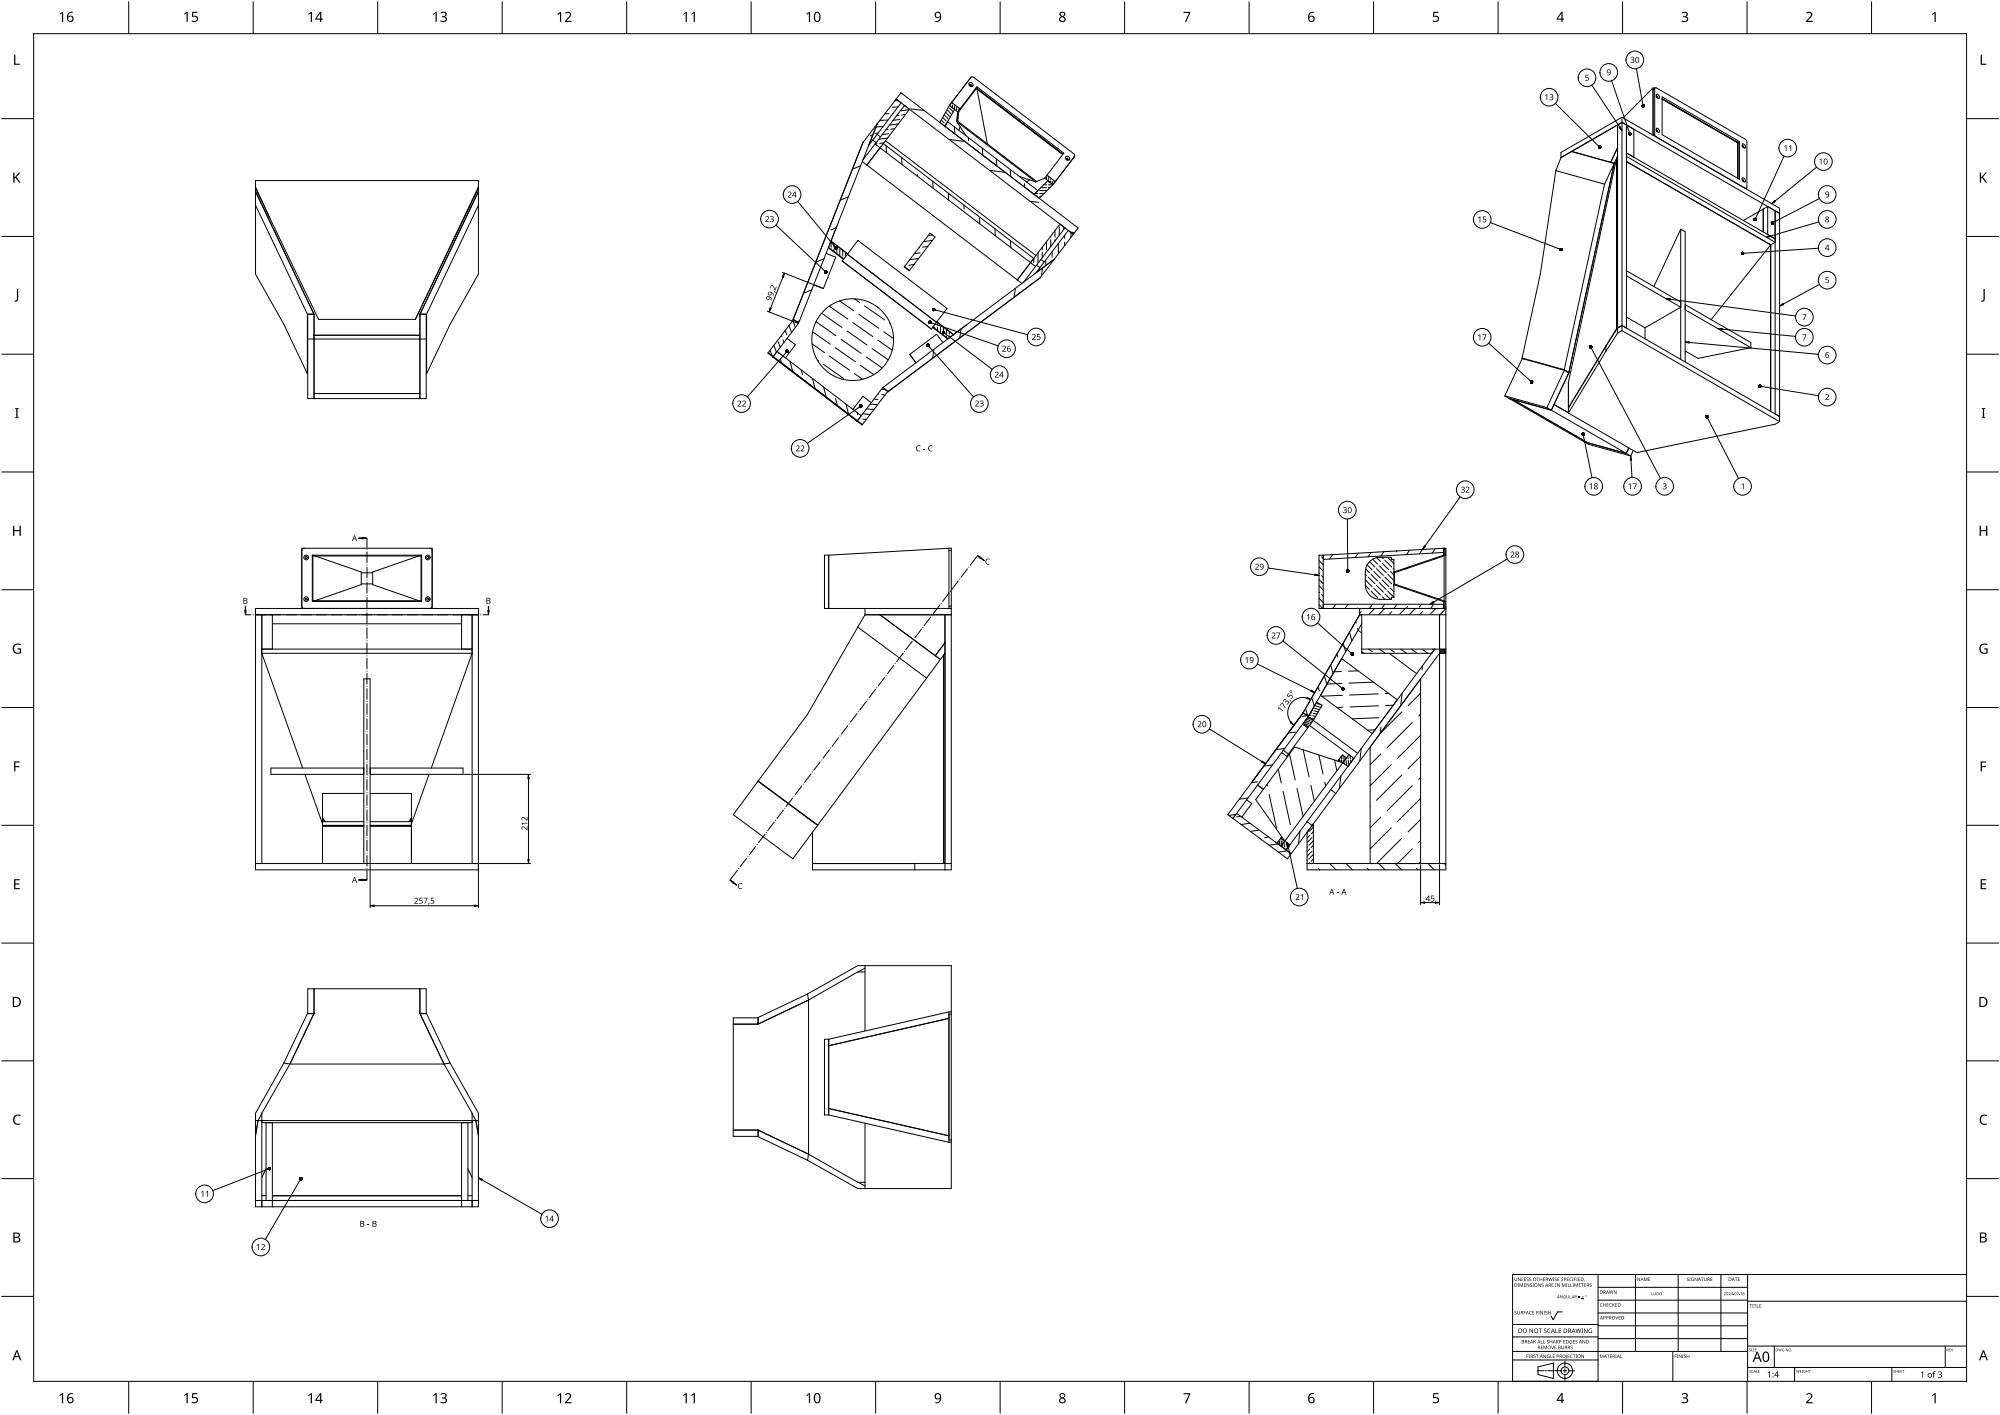
[picture p46: page 1]

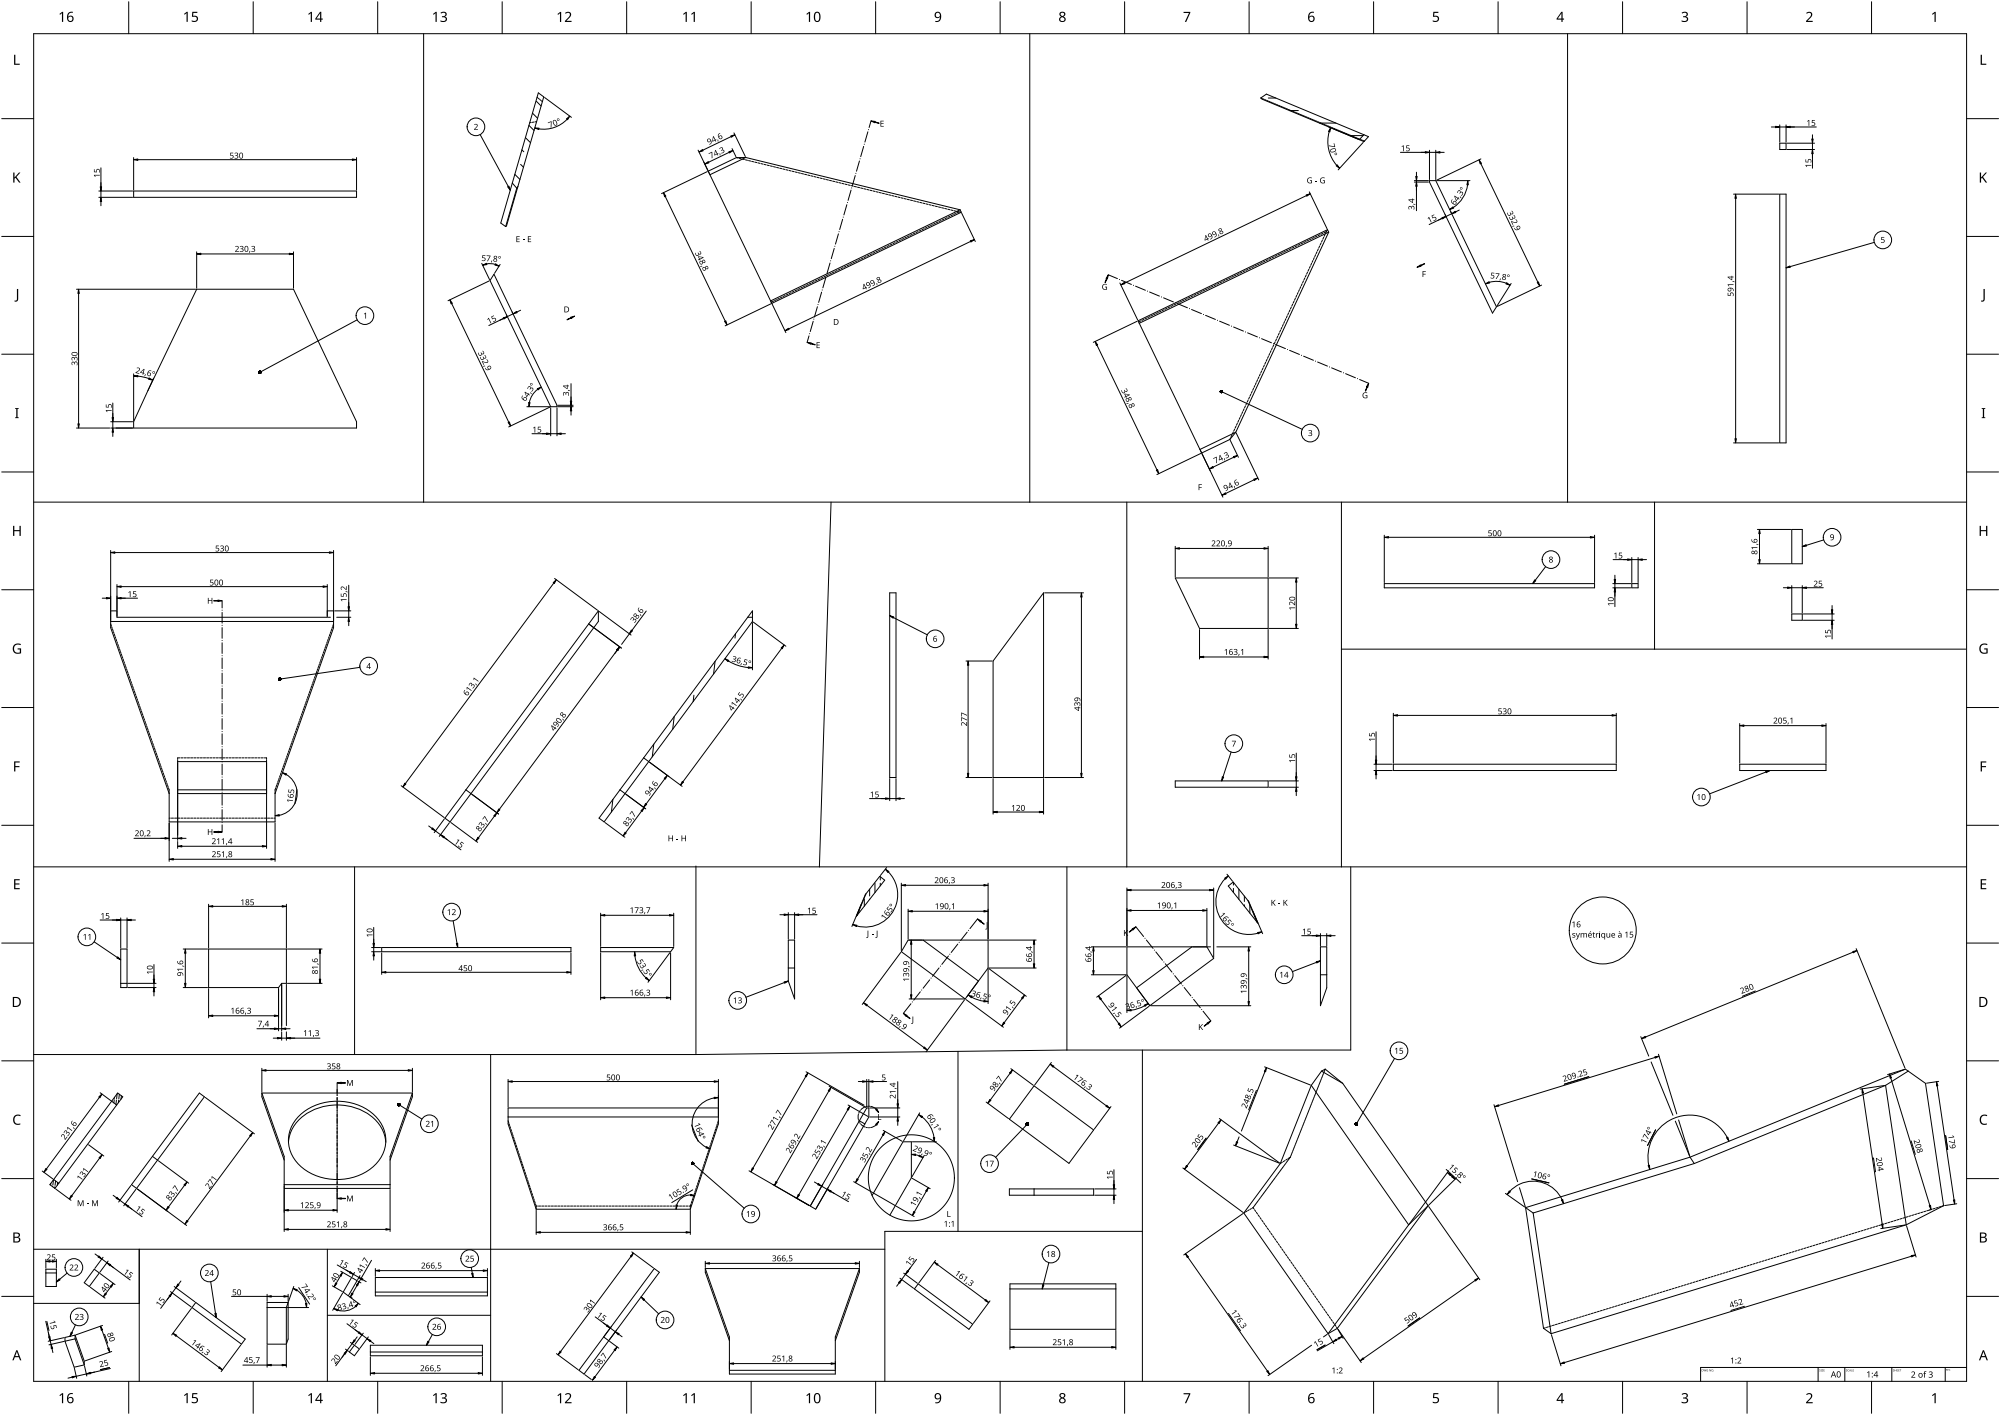
[picture p47: page 2]

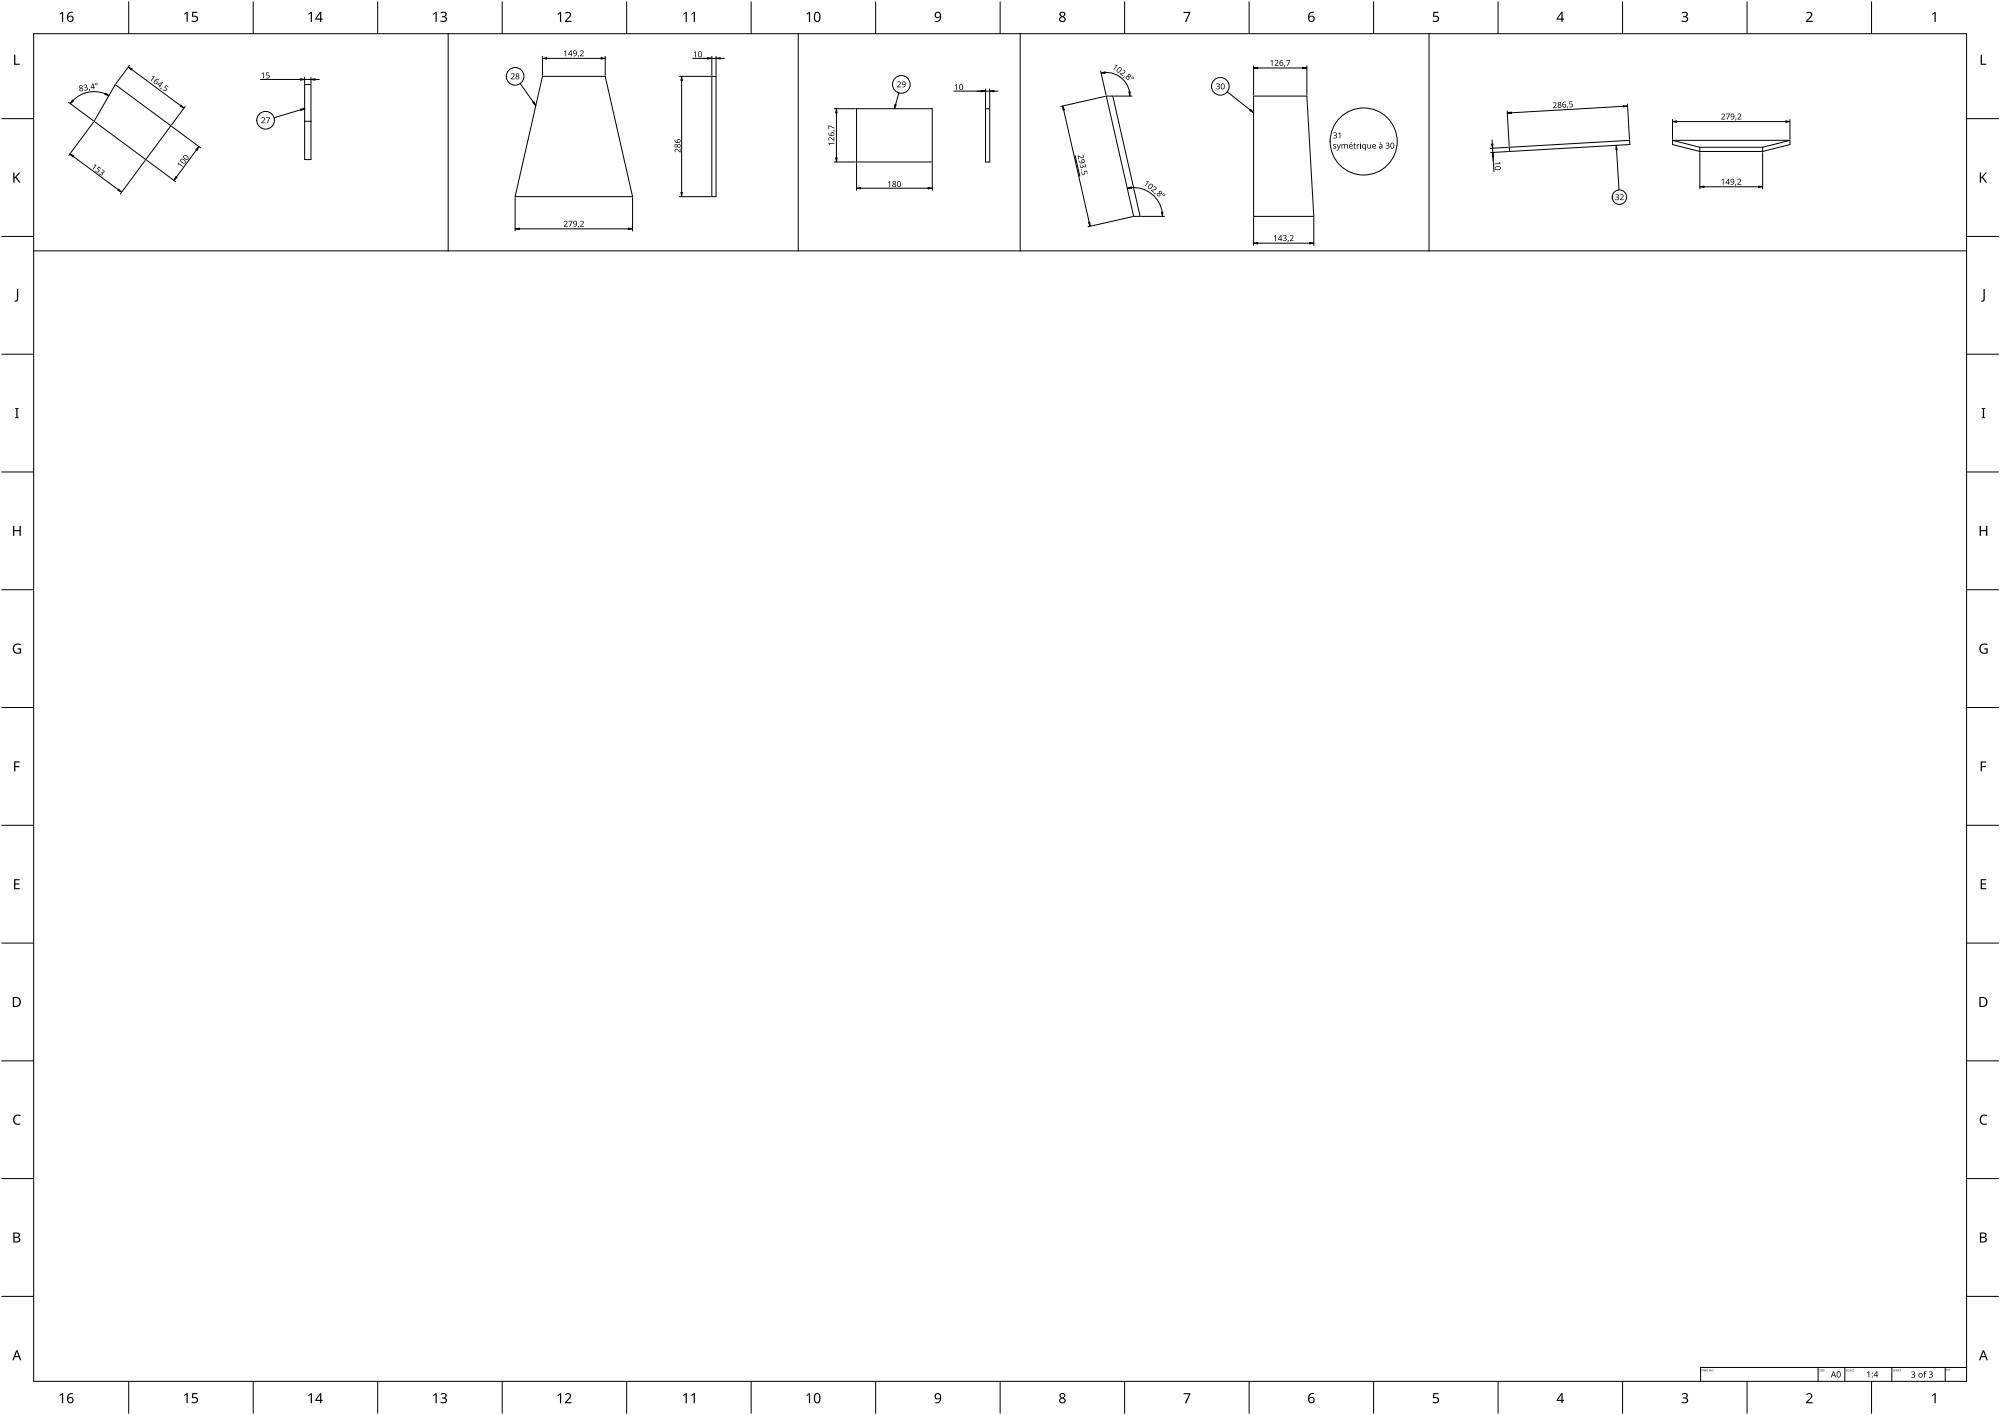
[picture p48: page 3]
